rkalsdud/MARCO/보고서/MARCO_Phase1-1_결과보고서.docx

MARCO 프로젝트

Motor And Real-time Control Over CAN

Phase 1-1 결과 보고서

HAL CAN 루프백 — 설계·구현·검증

2026년 7월 6일

정정(2026-10-25): 디버그 모드 제약(5.3절)의 원인 판단과 규칙, 이와 연결된 5.1 표·결론 문장을 정정했다. 틀린 문장은 지우지 않고 취소선으로 남겼고, 바로 아래에 정정 문단을 붙였다.

정정(2026-10-25): 4.4절 풀업 이유 문장과 6장 표 ISSUE 001 원인 칸도 같은 방식으로 정정했다.

항목 | 내용
대상 보드 | STM32 Nucleo-F446RE (STM32F446RET6, ARM Cortex-M4 @ 84MHz)
개발 환경 | VSCode + STM32CubeIDE 확장 + STM32CubeMX + CMake
단계 | Phase 1-1 — HAL CAN 루프백 코드 작성 및 보드 검증
목표 | CAN1 루프백 모드에서 8바이트 데이터 송수신 일치 확인
결과 | RX OK 출력 확인 ✅

# 목차

1. 개요 및 목표

✓ 작업 요약

• HAL 라이브러리로 CAN1 루프백 모드를 구성하고 RM0390 기준 500kbps 비트 타이밍(BRP=5, TS1=11, TS2=2)을 계산해 적용했다.

• CAN RX 핀(PB8) 풀업 미설정으로 인한 Start 타임아웃 등 5건의 이슈(001~005)를 진단·해결했다.

• 8바이트 송수신 데이터 일치(RX OK)를 Serial Monitor로 확인했다.

2. 하드웨어 구성

3. CAN 설정 — 비트 타이밍 계산

4. 소프트웨어 구현

5. 검증 결과

6. 트러블슈팅 요약

7. 데이터시트 확인 항목

8. 결론

# 1. 개요 및 목표

Phase 1-1은 HAL 라이브러리를 이용해 CAN 루프백 통신을 구현하고 보드에서 직접 검증하는 단계다. 루프백 모드는 CAN 컨트롤러가 자신이 송신한 메시지를 내부적으로 수신 FIFO에 돌려주는 모드다. 트랜시버와 두 번째 보드 없이 USB 케이블 하나만으로 CAN 송수신 코드를 검증할 수 있다.

## 1.2 목표

목표 | 완료 기준
CAN1 루프백 모드 설정 | HAL_CAN_Start() 성공 (CAN Start: 0 출력)
8바이트 데이터 송신 | TX OK 출력
수신 인터럽트 처리 | HAL_CAN_RxFifo0MsgPendingCallback 동작
송수신 데이터 일치 확인 | Serial Monitor에 RX OK 출력
printf 리디렉션 | USART2 → ST-LINK 가상 COM → PC 터미널

# 2. 하드웨어 구성

## 2.1 사용 장비

장비 | 모델 | 역할
개발 보드 | STM32 Nucleo-F446RE | 메인 MCU 보드
연결 케이블 | USB A to Mini-B | PC-보드 연결, ST-LINK 전원 공급 및 통신
개발 PC | Windows 11 | 코드 작성, 빌드, Serial Monitor

## 2.2 핀 구성 (UM1724 + DS10693 기준)

기능 | 핀 | 연결 대상 | 참조 문서
CAN1_RX | PB8 (AF9) | 루프백 내부 (배선 불필요) | UM1724, DS10693
CAN1_TX | PB9 (AF9) | 루프백 내부 (배선 불필요) | UM1724, DS10693
USART2_TX | PA2 (AF7) | ST-LINK → 가상 COM 포트 | UM1724
USART2_RX | PA3 (AF7) | ST-LINK → 가상 COM 포트 | UM1724
LD2 (User LED) | PA5 | 동작 상태 표시 (1초 토글) | UM1724

## 2.3 클럭 구성

클럭 | 값 | 설정 근거
HSI 오실레이터 | 16MHz | 내부 RC 오실레이터 사용
PLL 설정 | PLLM=16, PLLN=336, PLLP=DIV4 | SystemClock_Config 코드
SYSCLK (HCLK) | 84MHz | 16/16 × 336 / 4 = 84MHz
APB1 클럭 | 42MHz | HCLK / 2 = 42MHz
CAN1 클럭 소스 | APB1 = 42MHz | RM0390 18장 확인 (×2 아님)

# 3. CAN 설정 — 비트 타이밍 계산

## 3.1 목표 보드레이트

목표 보드레이트는 500kbps로 설정했다. 500kbps는 자동차 파워트레인 CAN 버스의 표준 속도 중 하나다 (ISO 11898 기준). 트랜시버 연결 시 두 노드가 동일한 보드레이트를 사용해야 통신이 가능하다.

## 3.2 비트 타이밍 계산 과정

RM0390 18장의 CAN_BTR 레지스터 설명을 기준으로 계산했다.

보드레이트 공식 (RM0390 18장):
보드레이트 = CAN 클럭 / ((1+BRP) × (1+TS1+TS2))

목표: 500kbps, CAN 클럭 = 42MHz
500,000 = 42,000,000 / ((1+BRP) × (1+TS1+TS2))
(1+BRP) × (1+TS1+TS2) = 42,000,000 / 500,000 = 84

84 인수분해 → BRP=5 선택: (1+5) × 14 = 84
TQ 길이 = (1+BRP) × APB 주기 = 6 / 42MHz = 142.857ns
1비트 = 14TQ × 142.857ns = 2000ns = 2μs ✅ 500kbps

샘플링 포인트 (권장 75~87.5%):
TS1=11, TS2=2 선택 → 1+11+2 = 14TQ
샘플링 포인트 = (1+TS1) / (1+TS1+TS2) = 12/14 = 85.7% ✅

## 3.3 최종 설정값

파라미터 | 값 | 의미 | 허용 범위 (RM0390)
Prescaler (BRP+1) | 6 (BRP=5) | TQ 클럭 분주 | BRP: 0~1023 (10비트)
TimeSeg1 (TS1) | 11TQ | 샘플링 전 구간 | TS1: 0~15 (4비트)
TimeSeg2 (TS2) | 2TQ | 샘플링 후 구간 | TS2: 0~7 (3비트)
SyncJumpWidth (SJW) | 1TQ | 재동기화 최대 보정폭 | SJW: 0~3 (2비트)
샘플링 포인트 | 85.7% | (1+11)/(1+11+2)×100 | 권장: 75~87.5%
실제 보드레이트 | 500kbps | 42MHz / 6 / 14 | 목표: 500kbps

# 4. 소프트웨어 구현

## 4.1 CAN 초기화 코드

static void MX_CAN1_Init(void) {
hcan1.Instance = CAN1;
hcan1.Init.Prescaler = 6; // BRP=5 → 500kbps
hcan1.Init.Mode = CAN_MODE_LOOPBACK; // 루프백 모드
hcan1.Init.SyncJumpWidth = CAN_SJW_1TQ;
hcan1.Init.TimeSeg1 = CAN_BS1_11TQ; // TS1=11
hcan1.Init.TimeSeg2 = CAN_BS2_2TQ; // TS2=2
hcan1.Init.TimeTriggeredMode = DISABLE;
hcan1.Init.AutoBusOff = DISABLE;
hcan1.Init.AutoWakeUp = DISABLE;
hcan1.Init.AutoRetransmission = ENABLE;
hcan1.Init.ReceiveFifoLocked = DISABLE;
hcan1.Init.TransmitFifoPriority = DISABLE;
HAL_CAN_Init(&hcan1);
}

## 4.2 필터 설정 (전체 ID 허용)

CAN_FilterTypeDef sf;
sf.FilterBank = 0;
sf.FilterMode = CAN_FILTERMODE_IDMASK;
sf.FilterScale = CAN_FILTERSCALE_32BIT;
sf.FilterIdHigh = 0x0000; // ID = 0
sf.FilterIdLow = 0x0000;
sf.FilterMaskIdHigh = 0x0000; // Mask = 0 → 모든 ID 통과
sf.FilterMaskIdLow = 0x0000;
sf.FilterFIFOAssignment = CAN_RX_FIFO0;
sf.FilterActivation = ENABLE;
sf.SlaveStartFilterBank = 14; // CAN1(0~13) / CAN2(14~27) 분할
HAL_CAN_ConfigFilter(&hcan1, &sf);

## 4.3 송수신 코드 구조

/* 전역 변수 */

volatile uint8_t g_txData[8] = {0x11,0x22,0x33,0x44,0x55,0x66,0x77,0x88};

volatile uint8_t g_rxFlag = 0; // 수신 완료 플래그

volatile uint8_t g_matchResult = 0; // 데이터 일치 여부

volatile uint16_t g_txError = 0; // 송신 실패 카운터

/* CAN 시작 + 인터럽트 활성화 (USER CODE BEGIN 2) */

HAL_StatusTypeDef startRet = HAL_CAN_Start(&hcan1);

printf("CAN Start: %d CAN_error: %lx\r\n", (int)startRet, hcan1.ErrorCode);

// startRet=0(HAL_OK) 이어야 정상 — ISSUE 001에서 이 값이 1로 나와 원인을 추적함

HAL_StatusTypeDef notifRet = HAL_CAN_ActivateNotification(&hcan1,

CAN_IT_RX_FIFO0_MSG_PENDING | CAN_IT_TX_MAILBOX_EMPTY);

printf("CAN Notif: %d CAN_error: %lx\r\n", (int)notifRet, hcan1.ErrorCode);

/* while 루프 — 1초마다 송신 (USER CODE BEGIN 3) */

CAN_TxHeaderTypeDef tx = {0};

uint32_t mailbox;

tx.StdId = 0x123; // 11비트 표준 ID

tx.IDE = CAN_ID_STD;

tx.RTR = CAN_RTR_DATA;

tx.DLC = 8; // 8바이트

HAL_StatusTypeDef ret = HAL_CAN_AddTxMessage(&hcan1, &tx, (uint8_t*)g_txData, &mailbox);

if (ret != HAL_OK) {

g_txError++;

printf("TX ERROR: %d HAL_status: %d CAN_error: %lx\r\n",

g_txError, ret, hcan1.ErrorCode);

} else {

printf("TX OK\r\n");

}

if (g_rxFlag) {

g_rxFlag = 0;

if (g_matchResult) {

printf("RX OK\r\n");

} else {

printf("RX ERROR\r\n");

}

}

HAL_GPIO_TogglePin(GPIOA, GPIO_PIN_5); // LD2 토글 — 송신 시각화

printf("loop\r\n");

HAL_Delay(1000);

/* 수신 인터럽트 콜백 */

void HAL_CAN_RxFifo0MsgPendingCallback(CAN_HandleTypeDef *hcan) {

CAN_RxHeaderTypeDef rx;

uint8_t rxData[8];

HAL_CAN_GetRxMessage(hcan, CAN_RX_FIFO0, &rx, rxData);

// 송신 데이터와 수신 데이터 8바이트 비교

uint8_t match = 1;

for (int i = 0; i < 8; i++) {

if (rxData[i] != g_txData[i]) { match = 0; break; }

}

g_matchResult = match;

g_rxFlag = 1;

}

/* printf 리디렉션 (USART2 → ST-LINK 가상 COM) */

int __io_putchar(int ch) {

HAL_UART_Transmit(&huart2, (uint8_t*)&ch, 1, HAL_MAX_DELAY);

return ch;

}

## 4.4 GPIO 핀 풀업 설정 (핵심)

CAN RX 핀(PB8)에 풀업 저항을 설정해야 한다. ~~이 설정 없이는 CAN 컨트롤러가 idle 상태의 recessive 비트(연속 11개 HIGH)를 감지하지 못해 HAL_CAN_Start()가 타임아웃된다.~~

정정(2026-10-25): 풀업 설정은 유지하되 이유는 확인된 범위로 좁힌다. RM0390 Rev 9는 정상 모드 진입 전에 CANRX에서 recessive 11비트를 기다린다고 적고(30.4, 1021쪽), 루프백에서는 CANRX 핀 값을 무시한다고 적는다(30.5.2, 1024쪽). 실측으로는 트랜시버 없이 RX 핀이 떠 있던 이 루프백 시험에서 풀업 없이 Start가 타임아웃됐고 풀업으로 해결됐다(ISSUE 001). 루프백에서도 핀 상태가 영향을 준 기제는 확인하지 않았다. 트랜시버 R 출력이 핀을 구동하는 구성에서 풀업이 필요한지는 확인되지 않았다.

/* stm32f4xx_hal_msp.c — HAL_CAN_MspInit */
GPIO_InitStruct.Pin = GPIO_PIN_8 | GPIO_PIN_9;
GPIO_InitStruct.Mode = GPIO_MODE_AF_PP;
GPIO_InitStruct.Pull = GPIO_PULLUP; // ← 핵심. NOPULL이면 Start 실패
GPIO_InitStruct.Speed = GPIO_SPEED_FREQ_VERY_HIGH;
GPIO_InitStruct.Alternate = GPIO_AF9_CAN1;
HAL_GPIO_Init(GPIOB, &GPIO_InitStruct);

# 5. 검증 결과

## 5.1 검증 환경

항목 | 설정
업로드 방법 | STM32CubeProgrammer → ELF 업로드 → RESET 버튼
모니터링 방법 | VSCode Serial Monitor (COM5, 115200 baud, 8N1)
실행 방법 | Run Without Debugging ~~(디버그 모드 사용 불가 — 5.3 참조)~~ 정정(2026-10-25): 디버그 모드 사용 가능 여부는 확인되지 않았다(5.3 정정). 실행은 CubeProgrammer 업로드 뒤 RESET이며, Run Without Debugging은 보드에 코드를 올리지 않는다(ISSUE 002).

## 5.2 Serial Monitor 출력 (정상 동작)

아래는 실제 검증 시 Serial Monitor 캡처 화면이다.

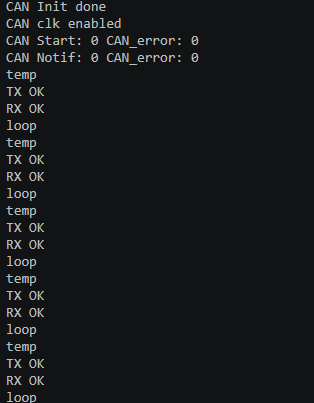
[picture p6: figure]

✓ 검증 완료 기준

HAL_CAN_Start() 반환값 0 (HAL_OK) → CAN 컨트롤러 정상 시작

TX OK → HAL_CAN_AddTxMessage() 성공

RX OK → 수신 인터럽트 발생 + 8바이트 데이터 일치 확인

loop → while 루프 1초 주기 정상 동작

LD2 → 1초 주기 토글 확인 (육안)

## 5.3 디버그 모드 제약

~~CAN은 실시간 페리퍼럴이다. GDB 디버거가 CPU를 브레이크포인트에서 멈추면, CAN 컨트롤러가 Init 모드(INAK)에서 정상 모드로 전환하는 타이밍이 깨진다. 그 결과 HAL_CAN_Start()가 0x20000 (Timeout) 에러를 반환한다.~~

정정(2026-10-25): ~~디버거가 원인이라는 판단은 근거가 성립하지 않는다.~~ 당시 CAN RX 핀(PB8)은 풀업 없이(GPIO_NOPULL) 떠 있었고, 디버거 없이 CubeProgrammer로 올려 RESET한 실행에서도 같은 0x20000이 났으며 풀업으로 바꾼 뒤 해결됐다(ISSUE 001). '디버거 없이 실행하니 정상'으로 본 실행은 보드에 새 코드를 올리지 않는 Ctrl+F5였다(ISSUE 002). 실제 원인은 RX 핀 풀업 누락일 가능성이 높다. ~~참고로 RM0390 Rev 9 기준 CAN_MCR의 DBF 리셋값은 1이라 코어가 디버그로 멈춘 동안 CAN 송수신이 동결된다(30.9.2, 1038쪽, 30.6).~~ 풀업 적용 뒤 디버그 실행으로 다시 시험하지 않았으며, Phase 3.7 작업 2에서 재시험한다.

재검토(2026-10-25): 위 정정 문단의 두 문장(취소선)은 단정이 과했다. 첫째, 같은 펌웨어를 디버거 없이 실행했을 때 정상 동작한 기록이 한 번 있다(Ctrl+F5 실행 때 보드에 남아 있던 펌웨어가 'TX OK'를 출력, 당시 대화). 그래서 디버거 가설에도 근거가 하나는 있었다. 다만 이후 디버거 없이 CubeProgrammer로 올린 실행에서도 같은 오류가 재현됐고 풀업으로 해결됐으므로, 디버거가 원인이라는 근거는 약하다. 핀이 떠 있으면 실행마다 결과가 달랐을 수 있다(추정). 둘째, DBF 리셋값은 1(디버그 중 송수신 동결로 기술)이지만, 30.6은 디버그 중 동작이 DBGMCU의 DBG_CANx_STOP 비트와 DBF 둘에 달려 있다고만 하고 조합 규칙은 적지 않아 '동결된다'고 단정할 수 없다.

⚠ CAN 검증 시 규칙

CAN 동작 확인: ~~Run Without Debugging +~~ STM32CubeProgrammer 업로드 + Serial Monitor

정정(2026-10-25): Run Without Debugging은 보드에 코드를 올리지 않는다(ISSUE 002). 업로드 뒤 RESET으로 실행한다.

변수 확인: printf 출력 방식으로 대체 (디버거 Watch 표현식 대신)

~~브레이크포인트: CAN Init/Start 이후 구간에서는 사용 금지~~

정정(2026-10-25): 근거가 확인되지 않은 규칙이다. 유지 여부는 Phase 3.7 작업 2의 디버그 재시험 뒤 정한다.

# 6. 트러블슈팅 요약

상세 내용은 MARCO_트러블슈팅_로그.docx를 참조한다.

번호 | 증상 | 원인 | 해결
001 | HAL_CAN_Start() 타임아웃 (error 0x20000) | CAN RX 핀(PB8) GPIO_NOPULL 설정 → ~~플로팅으로 recessive 비트 감지 불가~~ 정정(2026-10-25): 관측: 풀업 없이 Start가 타임아웃됐고 풀업으로 해결됐다. 루프백에서는 CANRX 핀 값을 무시한다는 RM0390 30.5.2와 어긋나 기제는 확인하지 않았다(4.4 정정). | GPIO_PULLUP으로 변경
002 | 코드 변경이 보드에 반영 안 됨 | ELF 파일을 PC에서 직접 실행 시도 | STM32CubeProgrammer로 플래시 업로드
003 | GDB 디버그 연결 실패 (error 138) | STM32CubeProgrammer가 ST-LINK를 점유한 채 실행 중 | CubeProgrammer 완전 종료 후 GDB 실행
004 | GDB 경로 디코딩 실패 | 프로젝트 경로에 한글 포함 | C:\Users\rkals\stm32-embedded-control으로 이동
005 | invalid storage class 빌드 에러 | while 루프 중괄호 불일치로 함수가 main 안에 중첩 | 중괄호 수정

7. 데이터시트 확인 항목

이 단계에서 직접 데이터시트를 열어 확인한 항목들이다. 코드 작성 및 배선의 근거가 된다.

항목 | 소스 | 찾은 내용 | 근거 위치
USART2_TX 핀 | UM1724 | PA2 | 7.10 USART communication 표
USART2_RX 핀 | UM1724 | PA3 | 7.10 USART communication 표
LD2 연결 핀 | UM1724 | PA5 | User LED 섹션
CAN1_TX 핀 | UM1724 + DS10693 | PB9 (AF9) | Morpho 커넥터 핀 배치표
CAN1_RX 핀 | UM1724 + DS10693 | PB8 (AF9) | Morpho 커넥터 핀 배치표
CAN1 클럭 소스 | RM0390 18장 | APB1 = 42MHz (×2 아님) | bxCAN 클럭 설명
CAN_BTR BRP 비트폭 | RM0390 18장 | 10비트 (0~1023) | CAN_BTR 레지스터
CAN_BTR TS1 비트폭 | RM0390 18장 | 4비트 (0~15) | CAN_BTR 레지스터
CAN_BTR TS2 비트폭 | RM0390 18장 | 3비트 (0~7) | CAN_BTR 레지스터
GPIO 최대 싱크 전류 | DS10693 | 25mA | Electrical characteristics

📌 데이터시트를 보지 않고 답변한 항목 (추후 확인 필요)

CAN 비트 타이밍 초기 계산값 (Prescaler=16, TimeSeg1=1TQ, TimeSeg2=1TQ) → 잘못된 값이었음

GPIO_NOPULL 설정 → 데이터시트 없이 기본값 사용 → CAN Start 실패 원인이 됨

위 두 항목은 실험적으로 발견하고 수정했으나 사전에 데이터시트로 확인했어야 했음

# 8. 결론

Phase 1-1의 목표를 달성했다. STM32F446RE의 CAN1 컨트롤러를 HAL 라이브러리로 루프백 모드에서 동작시키고, 8바이트 데이터의 송수신 일치를 Serial Monitor에서 확인했다.

이 과정에서 비트 타이밍 계산(RM0390 기준 500kbps), CAN RX 핀 풀업 설정, ~~디버거와 CAN 실시간 페리퍼럴의 충돌 등~~ 실무적인 이슈를 직접 경험하고 해결했다.

정정(2026-10-25): 디버거 충돌은 원인으로 확인되지 않았다(5.3절 정정).
