rkalsdud/MARCO/보고서/MARCO_Phase1-2_결과보고서.docx

MARCO 프로젝트

Motor And Real-time Control Over CAN

Phase 1-2 결과 보고서

CAN 트랜시버 배선 + 로직분석기 파형 검증

2026년 7월 7일

정정(2026-10-25): CAN 버스 전압과 로직분석기 임계값 서술(4장 박스, 5.2절)을 정정했다. 틀린 문장은 지우지 않고 취소선으로 남겼고, 바로 아래에 정정 문단을 붙였다.

정정(2026-10-25): 2.2 배선표의 CAN TX·CAN RX 행과 주의 박스도 같은 방식으로 정정했다.

보강(2026-10-26): 4장 박스의 재검토 문단 뒤에, 사용한 트랜시버 모듈 기판의 120Ω 종단저항을 실측으로 확인한 보강 문단을 붙였다.

항목 | 내용
대상 보드 | STM32 Nucleo-F446RE
추가 하드웨어 | SN65HVD230D CAN 트랜시버 모듈, TOL-18627 로직분석기 (24MHz/8ch)
단계 | Phase 1-2 — CAN 트랜시버 배선 + 로직분석기 파형 검증
목표 | 트랜시버를 통해 CAN 버스로 신호 출력 확인, PulseView로 프레임 디코딩
결과 | ID=0x123, DLC=8, Payload 일치 확인 ✅

# 목차

1. 개요 및 목표

✓ 작업 요약

• SN65HVD230D 트랜시버를 CAN1에 배선하고, 루프백 모드를 LOOPBACK(외부 출력 있음)으로 전환해 실제 신호를 트랜시버로 내보냈다.

• PulseView 로직분석기로 CAN_L 파형을 캡처해 ID=0x123, DLC=8, Payload 8바이트 일치를 확인했다.

• Silent 모드 오설정, 디코더 채널(CAN_H↔CAN_L) 오선택, 샘플레이트 부족 등 3건의 이슈(006~008)를 해결했다.

2. 하드웨어 구성 및 배선

3. 소프트웨어 설정

4. PulseView 설정

5. 검증 결과

6. 트러블슈팅 요약

7. 데이터시트 확인 항목

8. 결론

# 1. 개요 및 목표

Phase 1-2는 STM32 CAN1 컨트롤러와 SN65HVD230D 트랜시버를 연결하고, 로직분석기로 CAN_H/L 파형을 캡처해서 프레임 디코딩을 검증하는 단계다.

목표 | 완료 기준 | 결과
트랜시버 배선 | 전원 공급 + 신호선 연결 | ✅
로직분석기 CAN_L 파형 캡처 | 신호 변화 확인 | ✅
CAN 프레임 디코딩 | PulseView CAN 디코더 동작 | ✅
ID 확인 | 0x123 | ✅
DLC 확인 | 8바이트 | ✅
Payload 확인 | 0x11 0x22 0x33 0x44 0x55 0x66 0x77 0x88 | ✅

# 2. 하드웨어 구성 및 배선

## 2.1 사용 장비

장비 | 모델 | 역할
CAN 트랜시버 | SN65HVD230D 모듈 | CAN 컨트롤러 ↔ CAN 버스 신호 변환
로직분석기 | SparkFun TOL-18627 (24MHz/8ch) | CAN_H/L 파형 캡처
소프트웨어 | PulseView (sigrok) | 파형 시각화 + CAN 디코더

## 2.2 배선표

트랜시버 핀 | 연결 대상 | 비고
3.3V | STM32 CN6 4번 | 트랜시버 전원
GND | STM32 GND 핀 | 공통 GND
CAN TX | ~~STM32 PB8 (CN10 3번)~~ 정정(2026-10-25): STM32 PB9 (CN10 5번). 검증에 성공한 최종 배선 기준이다. 표의 값은 디버깅 중 TX·RX를 맞바꿔 시험한 배선으로 보인다(추정). | ~~트랜시버 입력 → STM32 CAN RX 방향 주의~~ 정정(2026-10-25): 모듈 'CAN TX'는 트랜시버 입력(D)이며 STM32 CAN1_TX(PB9)에 잇는다.
CAN RX | ~~STM32 PB9 (CN10 5번)~~ 정정(2026-10-25): STM32 PB8 (CN10 3번). | ~~트랜시버 출력 → STM32 CAN TX 방향 주의~~ 정정(2026-10-25): 모듈 'CAN RX'는 트랜시버 출력(R)이며 STM32 CAN1_RX(PB8)에 잇는다.
CAN H | 로직분석기 CH0 | CAN 버스 High 라인
CAN L | 로직분석기 CH1 | CAN 버스 Low 라인

⚠ 트랜시버 TX/RX 방향 주의

~~트랜시버 모듈의 'CAN TX'는 트랜시버 기준 명칭이다.~~

정정(2026-10-25): 모듈의 'CAN TX'·'CAN RX'는 STM32(CAN 컨트롤러) 쪽 신호 이름이다. 'CAN TX'(트랜시버 D 입력)에 PB9를, 'CAN RX'(R 출력)에 PB8을 잇는다. 아래 줄의 신호 방향은 최종 배선과 맞다.

STM32 PB9(CAN1_TX)의 신호를 트랜시버가 받아서 CAN 버스로 내보낸다.

모듈 핀 이름과 STM32 핀 이름의 TX/RX 방향이 혼동될 수 있어 배선 시 주의가 필요하다.

## 2.3 로직분석기 연결

로직분석기 핀 | 연결 대상 | PulseView 채널명
CH0 | 트랜시버 CAN H | CAN_H
CH1 | 트랜시버 CAN L | CAN_L
GND | STM32 GND 핀 | 기준 전위

## 2.4 배선 사진

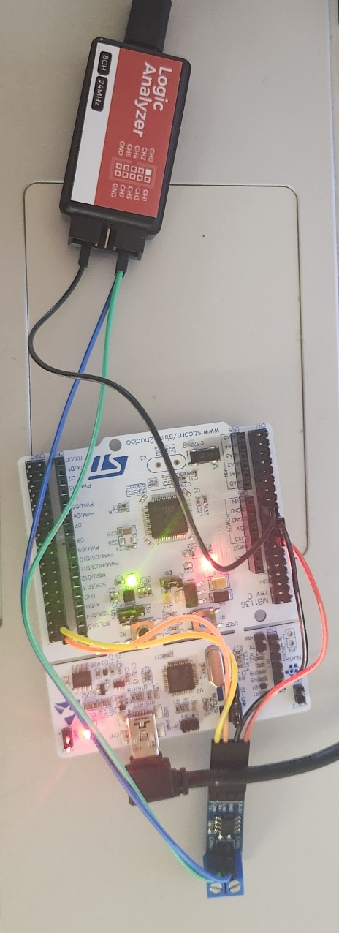
[picture p7: figure]

# 3. 소프트웨어 설정

## 3.1 비트 타이밍 계산 (500kbps)

RM0390 18장 CAN_BTR 레지스터 기준으로 계산했다. APB1 클럭은 SystemClock_Config에서 HCLK=84MHz, APB1DIV=2로 42MHz임을 확인했다.

파라미터 | 계산 | 결과
목표 보드레이트 | — | 500kbps (자동차 파워트레인 CAN 표준)
1비트 시간 | 1 / 500,000 | 2μs
총 TQ 수 결정 | 14TQ 선택 | 2μs / 14 = 142.857ns per TQ
BRP 계산 | 142.857ns = (1+BRP) / 42MHz → BRP=5 | Prescaler = 6
실제 보드레이트 검증 | 42MHz / 6 / 14 | 500kbps ✅
샘플링 포인트 | (1+11) / (1+11+2) = 12/14 | 85.7% (권장 75~87.5%) ✅

hcan1.Init.Prescaler = 6; // BRP+1, TQ = 6/42MHz = 142.857ns
hcan1.Init.SyncJumpWidth = CAN_SJW_1TQ;
hcan1.Init.TimeSeg1 = CAN_BS1_11TQ; // TS1 = 11TQ
hcan1.Init.TimeSeg2 = CAN_BS2_2TQ; // TS2 = 2TQ
// 42MHz / 6 / (1+11+2) = 500kbps, 샘플링 포인트 85.7%

## 3.2 CAN 모드 설정

트랜시버를 통해 외부 CAN 버스로 신호를 출력하려면 CAN_MODE_LOOPBACK으로 설정해야 한다. Silent 루프백 모드는 외부 핀으로 신호를 내보내지 않는다.

hcan1.Init.Mode = CAN_MODE_LOOPBACK; // 외부 TX 핀으로 신호 출력
hcan1.Init.AutoRetransmission = DISABLE; // ACK 없어도 동작

// CAN_MODE_SILENT_LOOPBACK은 외부 핀 신호 없음 → 사용 불가
// CAN_MODE_NORMAL은 ACK 필요 → 단일 노드에서 에러 발생

# 4. PulseView 설정

설정 항목 | 값 | 이유
Sample rate | 4MHz | 500kbps CAN 기준 비트당 8샘플 확보 (1MHz는 오독 발생)
Sample count | 1M | 0.25초 측정 (1초 주기 송신 기준 충분)
CAN 디코더 RX 채널 | CAN_L | Dominant 상태에서 CAN_L만 LOW로 변화
Nominal bitrate | 500000 | STM32 설정값과 일치
Sample point | 85.00 | 비트 타이밍 계산값 (85.7% 반올림)

📌 CAN 디코더를 CAN_L에 연결해야 하는 이유

~~Dominant(비트 0): CAN_H=3.5V(HIGH 유지), CAN_L=1.5V(LOW로 떨어짐)~~

~~Recessive(비트 1): CAN_H=2.5V(HIGH), CAN_L=2.5V(HIGH)~~

~~로직분석기 임계값 약 1.6V 기준으로 CAN_L의 1.5V만 LOW로 읽힘~~

정정(2026-10-25): 위 전압은 5V 트랜시버의 전형값으로, AI가 제공한 값을 데이터시트와 대조하지 않고 그대로 썼다. SN65HVD230(TI SLOS346O 8.5절, 7쪽, 3.3V 전원 기준): dominant에서 CANH 2.45V~VCC, CANL 0.5~1.25V, recessive에서 CANH·CANL 전형 2.3V, dominant 차동 전압 전형 2V. 로직분석기(SparkFun TOL-18627 제품 개요)는 LOW ≤ 0.8V, HIGH ≥ 2.0V이고 그 사이는 판독이 보장되지 않는다. "임계값 약 1.6V"는 출처가 없다. CAN_L 디코딩이 된 것은 실제 문턱이 당시 CANL 전압보다 높았기 때문이며(관측), 문턱과 버스 전압은 측정하지 않았다(버스 전압 실측은 Phase 5-a 작업 2).

재검토(2026-10-25): 위 SN65HVD230 값은 데이터시트 시험 조건(부하 저항 포함, Figure 18·19)의 값이다. 이 단계의 배선표에는 종단저항이 없으므로 실제 버스 전압은 이와 달랐을 수 있고, 측정하지 않았다.

보강(2026-10-26): 위 재검토의 '배선표에는 종단저항이 없으므로'는 배선표 기준의 서술이다. 사용한 SN65HVD230 모듈은 기판에 120Ω 칩저항(표기 121)이 실장된 제품이라(2026-10-26 실측, 모듈 단독 CANH–CANL 약 120Ω) 이 단계의 버스에는 그 120Ω 하나가 걸려 있었다. 데이터시트 시험 조건의 부하와 다르므로 버스 전압이 위 값과 달랐을 수 있다는 결론은 같고, 버스 전압은 측정하지 않았다. (Claude 작성, 외부 검토 전)

교훈(2026-10-25): 수치는 출처가 무엇이든 받아들이기 전에 데이터시트와 대조한다(트러블슈팅 로그 ISSUE 022 정정 이력과 같은 교훈).

CAN_H는 항상 HIGH라 변화 감지 불가

# 5. 검증 결과

## 5.1 PulseView 캡처 결과

아래는 실제 검증 시 PulseView 파형 캡처 화면이다. CAN_L에 펄스가 보이고 CAN: Fields에서 ID, DLC, Payload가 디코딩된다.

확인 항목 | 기대값 | 측정값 | 결과
Identifier (ID) | 0x123 (291) | 0x123 (291) | ✅
DLC | 8바이트 | 8바이트 | ✅
Payload | 11 22 33 44 55 66 77 88 | 11 22 33 44 55 66 77 88 | ✅
CAN_L 파형 | Dominant 구간에서 LOW | LOW 구간 확인 | ✅
프레임 주기 | 약 1초 | 1초 주기 반복 | ✅

✓ Phase 1-2 검증 완료

트랜시버가 STM32 CAN 신호를 CAN 버스 차동 신호로 정상 변환하고 있음

PulseView에서 ID, DLC, Payload 모두 일치 확인

CAN 프레임 구조 (SOF, ID, DLC, Data, CRC, EOF) 정상 디코딩

## 5.2 로직분석기 한계 사항

일반 디지털 로직분석기는 CAN 차동 신호를 직접 측정하지 못한다. CAN_H/L 전압 레벨~~(Dominant: H=3.5V/L=1.5V, Recessive: 둘 다 2.5V)~~을 정확히 측정하려면 차동 프로브 또는 멀티미터가 필요하다.

정정(2026-10-25): SN65HVD230 기준값은 4장 박스의 정정 문단 참조. 위 괄호의 값은 5V 트랜시버 전형값이다.

⚠ 로직분석기 측정 한계

CAN idle 상태: ~~CAN_H=2.5V, CAN_L=2.5V~~ → 로직분석기는 둘 다 HIGH로 읽음

Dominant 상태: ~~CAN_L=1.5V → 로직분석기 임계값(약 1.6V) 이하라~~ LOW로 읽힘

CAN_H는 항상 HIGH로 읽혀 파형 변화 미감지

정확한 전압 측정은 멀티미터 필요 (현재 미보유)

정정(2026-10-25): 위 두 줄의 전압과 임계값은 근거가 없다. recessive는 CANH·CANL 전형 2.3V, dominant CANL은 0.5~1.25V이며, 로직분석기 판독 기준은 LOW ≤ 0.8V, HIGH ≥ 2.0V다(4장 박스 정정). dominant CANL은 보장되지 않는 구간에 걸치지만 실제로는 LOW로 읽혔다(관측).

재검토(2026-10-25): SN65HVD230 값은 데이터시트 시험 조건(부하 포함) 기준이다(4장 박스 재검토).

# 6. 트러블슈팅 요약

상세 내용은 MARCO_트러블슈팅_로그.docx를 참조한다.

번호 | 증상 | 원인 | 해결
006 | PB9에서 신호 없음 | CAN_MODE_SILENT_LOOPBACK은 외부 핀으로 신호 미출력 | CAN_MODE_LOOPBACK으로 변경
007 | PulseView CAN 디코더 동작 안 함 | CAN RX 채널을 CAN_H로 설정 → 변화 감지 불가 | CAN RX 채널을 CAN_L로 변경
008 | Payload 오독 (일부 바이트 틀림) | Sample rate 1MHz → 비트당 2샘플로 부족 | Sample rate 4MHz로 상향

7. 데이터시트 확인 항목

이 단계에서 직접 데이터시트를 열어 확인한 항목들이다.

항목 | 소스 | 찾은 내용 | 근거 위치
CAN1_TX/RX Morpho 위치 | UM1724 | PB8=CN10 3번, PB9=CN10 5번 | 커넥터 핀 배치표
SN65HVD230 핀 배치 | SN65HVD230 데이터시트 | D=1, GND=2, VCC=3, R=4, Vref=5, CANL=6, CANH=7, Rs=8 | Pin configuration
Rs 핀 모드 | SN65HVD230 데이터시트 | GND=고속모드, 저항=슬로프제어 | Rs 핀 설명
APB1 최대 클럭 | DS10693 | 42MHz (Over-drive OFF) | Internal APB1 clock frequency 표
TIM3 최대 타이머 클럭 | DS10693 | 90MHz (TIMPRE=0) | Table 60. TIMx characteristics
TIMPRE 리셋값 | RM0390 RCC 장 | 0 (RCC_DCKCFGR 리셋값 0x0) | RCC_DCKCFGR 레지스터
TIM3 클럭 계산 | RM0390 RCC 장 | APB1 prescaler>1 → ×2 = 84MHz | TIMPRE=0 타이머 클럭 설명
500kbps 비트 타이밍 | RM0390 18장 | BRP=5, TS1=11, TS2=2, 샘플링포인트 85.7% | CAN_BTR 레지스터

⚠ 데이터시트 확인 없이 진행했던 항목

CAN_MODE_SILENT_LOOPBACK 동작 → 외부 신호 없음을 몰라서 시행착오 발생

PulseView CAN RX 채널 → CAN_H/CAN_L 차이를 실험으로 확인 (사전에 CAN 물리 계층 이해로 예측 가능)

Sample rate → 나이퀴스트 기준으로 사전 계산 가능했지만 실험적으로 확인

# 8. 결론

Phase 1-2의 목표를 달성했다. SN65HVD230D 트랜시버를 STM32 CAN1 컨트롤러에 연결하고, PulseView 로직분석기로 CAN_L 파형을 캡처해서 ID=0x123, DLC=8, Payload 완전 일치를 확인했다.
