rkalsdud/MARCO/보고서/MARCO_Phase1-7_결과보고서.docx

MARCO 프로젝트

Motor And Real-time Control Over CAN

Phase 1-7 결과 보고서 — HAL → 베어메탈 전환

2026년 7월 28일 완료

정정(2026-10-25): CAN RX 풀업 서술(4.1 표, 5.3 박스)과 관련 ISSUE 번호(4.5·5.3 박스)를 정정했다. 틀린 문장은 지우지 않고 취소선으로 남겼고, 바로 아래에 정정 문단을 붙였다.

정정(2026-10-25): 1.1 목적 문장, 7장 페리퍼럴 개수, 9장 이슈 목록도 같은 방식으로 정정했다.

정정(2026-10-25): 3장 대조 항목 수와 4.4 SMPR1 행도 같은 방식으로 정정·보강했다.

GPIO/PWM/CAN/ADC 베어메탈 전환 및 최종 코드 정리(죽은 HAL 코드 제거)까지 완료한 최종 보고서다.

# 1. 개요

✓ 작업 요약

• GPIO, PWM, CAN1/CAN2, ADC를 각각 HAL 버전과 베어메탈 버전으로 구현하고 데이터시트(RM0390, DS10693) 기준으로 레지스터 값을 전수 검증했다.

• 레지스터 참조표와 HAL↔베어메탈 함수 대응표를 정리해 각 레지스터/함수의 역할을 문서화했다.

• 베어메탈 전환 과정에서 발생한 6건의 이슈(핀 AF 누락, 풀업 누락 등)를 진단·해결했다.

## 1.1 목적

Phase 1-1~1-6에서 HAL 라이브러리로 구현한 GPIO, PWM, CAN 초기화 및 제어 코드를 CMSIS 레지스터 직접 조작(베어메탈) 방식으로 전환한다. HAL이 내부적으로 수행하는 레지스터 조작을 데이터시트(RM0390, DS10693) 기준으로 직접 확인하고 재구현함으로써, ~~추상화 계층 없이도 페리퍼럴을 완전히 이해하고 제어할 수 있음을 증명한다.~~

정정(2026-10-25): 과장이다. 베어메탈 ADC 초기화에 ADC 클럭 분주(ADC_CCR.ADCPRE) 설정이 없어 ADC 클럭이 42MHz(PCLK2 84MHz ÷ 리셋값 2)로 DS10693 상한 36MHz를 넘었다(외부평가 A7, Phase 1-5 3.1 보강). 이 단계의 범위는 HAL로 구현한 동작을 레지스터 직접 조작으로 재현한 것까지다.

## 1.2 대상 범위

대상 | 전환 상태 | 비고
GPIO (모터 방향 제어: PC0/PC1/PC2) | 완료 ✅ | BSRR 기반, HAL과 동일 파형 확인
PWM (TIM3, PA6) | 완료 ✅ | PA6 AF2 설정 포함, 1kHz 유지
CAN (CAN1, 루프백) | 완료 ✅ | 필터/BTR/인터럽트 포함, match=1 확인
ADC (가변저항, PC3) | 완료 ✅ | Phase 1-5에서 배선 및 실측 검증 완료
HAL 초기화 완전 제거 | 완료 ✅ | 9장 참조 — 본 문서에서 일괄 정리 완료

## 1.3 진행 순서

가변저항 부품이 도착하지 않은 상태에서 순서를 조정해 진행했다. ADC를 제외한 GPIO → PWM → CAN 순으로 먼저 전환하고, ADC 베어메탈 코드는 부품 도착 후 이어서 작성하기로 했다.

# 2. 계산 근거

## 2.1 시스템 클럭 구성

HSI(16MHz) → PLL → SYSCLK 84MHz. APB1 타이머 클럭 84MHz, APB2 84MHz (SystemClock_Config 기준).

## 2.2 PWM (TIM3) 주파수/듀티 계산

항목 | 값 | 계산식
PSC | 83 | 84MHz / (83+1) = 1MHz
ARR | 999 | 1MHz / (999+1) = 1kHz
CCR1 (듀티) | 0~999 | duty / 1000 × 100%
실사용 듀티 | 750 | 750/1000 = 75%

## 2.3 CAN 비트 타이밍 계산

HAL 설정값(Prescaler=6, BS1=11TQ, BS2=2TQ) 기준으로 베어메탈 BTR 레지스터에 대응하는 값을 아래와 같이 산출했다.

BTR 필드 | 설정값 | 의미
BRP[9:0] | 5 | Prescaler = BRP+1 = 6
TS1[19:16] | 10 | BS1 = TS1+1 = 11TQ
TS2[22:20] | 1 | BS2 = TS2+1 = 2TQ
SJW[25:24] | 0 | SJW = SJW+1 = 1TQ
LBKM[30] | 1 | 루프백 모드 활성화

1 비트 시간 = 1(동기) + 11(BS1) + 2(BS2) = 14 TQ. 이 값과 BRP를 조합해 500kbps 근사 통신속도를 구성했다 (HAL 설정과 동일).

# 3. 구현 — 데이터시트 대조 검증

베어메탈 가이드 문서에 기재한 레지스터 비트 위치를 RM0390/DS10693에서 직접 대조해 전수 검증했다. 전체 18개 항목 모두 문서 기재값과 일치함을 확인했다.

보강(2026-10-25): 아래 표는 16행이다. 18은 필드 단위로 센 값일 수 있으나 세는 기준은 확인하지 않았다. 또 이 대조는 가이드 문서에 적은 비트 위치를 확인한 것이라, 가이드에 없던 설정은 대상이 아니었다. ADC 클럭 분주(ADC_CCR.ADCPRE) 누락은 이 대조로 잡히지 않았다(외부평가 A7, 1.1 정정).

레지스터 | 필드 | 값 | 확인
RCC AHB1ENR | GPIOAEN / GPIOCEN | 비트0 / 비트2 | ✅
RCC APB1ENR | TIM3EN / CAN1EN | 비트1 / 비트25 | ✅
RCC APB2ENR | ADC1EN | 비트8 | ✅
GPIOx_MODER | 모드값 4종 | 00/01/10/11 | ✅
GPIOx_OTYPER | Push-Pull/Open-Drain | 0/1 | ✅
GPIOx_BSRR | SET/RESET | 하위16/상위16 | ✅
GPIOx_AFR | 핀당 비트폭 | 4비트 | ✅
DS10693 | PA6 / PC3 | AF2(TIM3_CH1) / ADC123_IN13 | ✅
TIMx_CCMR1 | OC1M | [6:4], 110=PWM1 | ✅
TIMx_CCER | CC1E | 비트0 | ✅
TIMx_CR1 | CEN | 비트0 | ✅
TIMx_PSC/ARR | 비트폭 | 16비트 | ✅
CAN_BTR | BRP/TS1/TS2/SJW/LBKM | 본문 2.3 참조 | ✅
ADC CR2 | ADON/SWSTART | 비트0 / 비트30 | ✅
ADC SR | EOC | 비트1 | ✅
ADC SQR3 | SQ1 | [4:0] | ✅

# 4. 레지스터 참조표

3장이 값의 정확성(데이터시트 일치 여부)을 다뤘다면, 이 장은 각 레지스터가 실제로 무슨 역할을 하며 왜 우리 코드에 필요한지를 정리한다. 나중에 이 문서만 보고도 레지스터의 기능을 떠올릴 수 있도록 하는 것이 목적이다.

## 4.1 GPIO

레지스터 | 역할 | 이 프로젝트에서의 목적
MODER | 핀의 기본 동작 모드 결정 (입력/출력/AF/아날로그) | PC0~PC2를 출력으로, PA6/PC3을 AF·아날로그로 전환
OTYPER | 출력 방식 결정 (Push-Pull/Open-Drain) | 모터 제어 핀을 Push-Pull로 설정해 HIGH/LOW를 능동 구동
BSRR | 핀을 원자적으로 SET/RESET | STBY/AIN0/AIN1을 read-modify-write 없이 안전하게 제어
AFR[0]/AFR[1] | 핀을 특정 페리퍼럴 신호선에 연결 | PA6→TIM3_CH1(AF2), PB8/PB9→CAN1(AF9) 매핑
PUPDR | 입력 핀의 유휴 상태 고정 (풀업/풀다운) | ~~CAN1_RX(PB8)를 풀업해 버스 유휴 상태(recessive)를 안정적으로 유지~~ 정정(2026-10-25): CAN1_RX(PB8)에 풀업을 건다. RX 핀이 떠 있는 구성에서 정상 모드 진입이 실패한 이력(ISSUE 001)에 대한 대비이며, 트랜시버가 핀을 구동하는 구성에서 필요한지는 확인되지 않았다(트러블슈팅 로그 ISSUE 001 교훈 정정).

## 4.2 TIM3 (PWM)

레지스터 | 역할 | 이 프로젝트에서의 목적
PSC | 타이머 입력 클럭을 분주 | 84MHz → 1MHz로 낮춰 다루기 쉬운 카운트 단위 확보
ARR | 카운터가 리셋되는 상한값 (주기 결정) | 999로 설정해 1kHz PWM 주기 생성
CCR1 | 채널1의 비교값 (듀티 결정) | 값이 클수록 HIGH 구간이 길어져 모터 속도 증가
CCMR1 (OC1M) | 채널의 출력 비교 동작 모드 선택 | PWM mode 1(110)로 설정해 CCR1 이하 구간에서 HIGH 출력
CCER (CC1E) | 채널 출력을 실제 핀에 연결할지 결정 | 내부 PWM 신호를 PA6 핀까지 실제로 내보내는 스위치 역할
CR1 (CEN) | 타이머 카운터 동작 시작/정지 | 모든 설정이 끝난 뒤 마지막에 켜서 타이머 시작

## 4.3 CAN1

레지스터 | 역할 | 이 프로젝트에서의 목적
MCR (INRQ) | 초기화 모드 진입/해제 요청 | 설정 변경 전 초기화 모드로, 완료 후 Normal 모드로 전환
MSR (INAK) | 초기화 모드 진입 완료를 하드웨어가 확인 | INRQ 요청에 대한 응답 대기 — 핸드셰이크 구조
BTR | 비트 타이밍(BRP/TS1/TS2/SJW) 및 루프백 모드 | 500kbps 근사 통신 속도 구성, 테스트용 루프백 활성화
MCR (NART) | 자동 재전송 여부 | 0으로 설정해 실패한 프레임을 자동 재전송하도록 함
FMR (FINIT) | 필터 뱅크 설정 모드 잠금/해제 | 필터값을 바꾸는 동안 수신에 영향 없도록 보호
FA1R | 필터 뱅크 활성화 여부 | 필터 뱅크 0번을 사용하도록 활성화
sFilterRegister (FR1/FR2) | 필터 ID값과 마스크값 | 마스크 전부 0 → 모든 ID를 허용(전체 수신)
IER (FMPIE0) | FIFO0 메시지 수신 인터럽트 활성화 | 메시지 도착 시 인터럽트로 즉시 처리하기 위함
TSR / TIR / TDTR / TDLR / TDHR | 송신 메일박스 상태 확인 및 프레임 구성 | 메일박스가 빈 것을 확인 후 ID/길이/데이터를 채워 송신
RF0R | 수신 FIFO0 상태, 메시지 존재 여부 및 릴리즈 | 메시지 유무 확인 및 처리 후 FIFO 슬롯 반환

## 4.4 ADC1

레지스터 | 역할 | 이 프로젝트에서의 목적
CR2 (ADON) | ADC 회로 전원 스위치 | 변환 전 ADC 하드웨어를 활성화
CR2 (SWSTART) | 소프트웨어 트리거로 변환 시작 | 가변저항 값 측정이 필요한 시점마다 변환 개시
SQR3 (SQ1) | 정규 변환 시퀀스의 1번째 채널 지정 | 채널13(PC3)을 유일한 변환 대상으로 지정
SMPR1 | 채널별 샘플링(충전) 시간 설정 | ~~느리게 변하는 가변저항 신호라 기본 3 cycles로 충분~~ 정정(2026-10-25): 근거 미확인. ~~3 cycles를 고른 근거는 기록돼 있지 않고,~~ DS10693의 외부 입력 임피던스 조건(Table 74 RAIN, Equation 1)과 대조하지 않았다(외부평가 A7). 당시 ADC 클럭은 사양 밖(42MHz)이었다. 재검토(2026-10-25): 취소선 구절은 사실과 다르다. 3 cycles는 CubeMX·HAL 설정값(ADC_SAMPLETIME_3CYCLES)을 그대로 옮긴 것이다(당시 대화 기록). 보고서에 그 출처를 적지 않았고, 전기적 근거(RAIN, Equation 1)와는 대조하지 않았다.
SR (EOC) | 변환 완료 여부 플래그 | 이 비트가 설 때까지 대기한 뒤 결과를 읽어야 정확한 값 확보
DR | 변환 결과 12비트 값 저장 | 읽는 순간 EOC가 자동으로 클리어됨

## 4.5 HAL 함수 ↔ 베어메탈 함수 대응표

4.1~4.4가 레지스터 단위의 대응이라면, 이 절은 실제 코드에서 호출하는 함수 단위의 대응이다. 각 페리퍼럴마다 HAL 버전과 베어메탈 버전 함수를 나란히 만들어 성능 비교(Phase 2) 및 상호 검증에 활용했다.

동작 | HAL 방식 | 베어메탈 함수 | 비고
모터 정방향 | Motor_Forward() (HAL_GPIO_WritePin ×3) | Motor_Forward_Bare()
모터 역방향 | Motor_Backward() (HAL_GPIO_WritePin ×3) | Motor_Backward_Bare()
모터 정지 | Motor_Stop() (HAL_GPIO_WritePin) | Motor_Stop_Bare()
PWM 듀티 설정 | Motor_SetSpeed() (__HAL_TIM_SET_COMPARE) | Motor_SetSpeed_Bare() | 매크로 기반, 성능差 없음
ADC 값 읽기 | ADC_Read() (HAL_ADC_Start 등 4개 함수) | ADC_Read_Bare() | MX_ADC1_Init() 없이는 미동작
TIM3 PWM 초기화 | MX_TIM3_Init() + HAL_TIM_PWM_Start() | TIM3_PWM_Init_Bare() | PA6 AF 설정 포함
CAN1 초기화 | MX_CAN1_Init() + Config/Start/Notify | CAN1_Init_Bare() | 필터·BTR·인터럽트 포함
ADC1 초기화 | MX_ADC1_Init() | ADC1_Init_Bare() | SQR3·SMPR1 포함

⚠ 함께 쓸 때 주의할 점

• HAL 버전 함수는 대응하는 MX_..._Init() 이 호출된 상태에서만 정상 동작한다.

• 베어메탈로 전환한 뒤 HAL 버전 함수(예: ADC_Read())를 그대로 호출하면, HAL 내부 핸들 구조체가 초기화되지 않아 조용히 실패하거나 아무 값도 반환하지 않는다.

• 두 버전을 비교 목적으로 남겨둘 때는 이 제약을 항상 염두에 두고, 실제 실행 경로에는 베어메탈 버전만 남기는 것이 안전하다 ~~(ISSUE 002, 014와 같은 원인)~~.

정정(2026-10-25): 같은 원인의 이슈는 초기화되지 않은 HAL 핸들을 쓴 ISSUE 025·027이다. ISSUE 002(ELF를 PC에서 실행)와 014(HAL과 베어메탈 동시 초기화)는 원인이 다르다.

# 5. 검증

## 5.1 GPIO 베어메탈

로직분석기로 PC0/PC1/PC2 파형을 HAL 버전과 비교해 동일함을 확인했다. Forward/Backward/Stop 3개 상태 전환이 정상 동작했다.

## 5.2 PWM 베어메탈

PA6 파형이 1kHz로 정상 출력됨을 확인했다. AF 설정 누락 시 UART까지 영향을 받는 부수 효과를 ISSUE 013에서 확인했다 (상세는 트러블슈팅 로그 참조).

## 5.3 CAN 베어메탈

초기화, 필터, 비트 타이밍, 인터럽트까지 전 구간을 베어메탈로 전환한 뒤 루프백 송수신 테스트에서 match=1(송수신 데이터 일치)을 확인했다. 전환 과정에서 총 6건의 이슈(013~018)가 발생했으며 전부 해결했다.

⚠ 반복적으로 발생한 패턴

• CAN RX 핀(PB8) 풀업 누락이 ISSUE 001과 ISSUE 017에서 두 차례 재발했다.

보강(2026-10-25): 풀업 없이 실패가 확인된 구성은 RX 핀을 구동하는 것이 없던 ISSUE 001이다. ISSUE 017 시점의 트랜시버 연결 여부는 기록이 엇갈린다. "RX 핀에는 반드시 풀업"으로 일반화하지 않는다.

• HAL의 MspInit 계열 함수가 레지스터 설정 외에도 핀 AF 설정을 함께 수행하고 있어, 이를 놓치면 초기화 단계에서 정지하는 문제가 반복됐다 (ISSUE 016).

• 동일 페리퍼럴을 HAL과 베어메탈로 동시에 초기화하면 상태가 꼬인다 ~~(ISSUE 002, 014)~~.

정정(2026-10-25): ISSUE 002는 ELF를 PC에서 실행하려 한 문제라 해당하지 않는다. 해당 이슈는 ISSUE 014다.

# 6. 트러블슈팅 요약

본 단계에서 발생한 이슈 목록이다. 상세 원인 분석과 해결 과정은 MARCO_트러블슈팅_로그.docx를 참조한다.

번호 | 제목 | 핵심 원인 | 상태
013 | AFR 클리어 시 UART 먹통 | ~ 연산자 누락 | 해결 ✅
014 | CAN 0xC0000 에러 | HAL/베어메탈 CAN 동시 초기화 | 해결 ✅
015 | g_txData undefined reference | extern 선언 누락 | 해결 ✅
016 | CAN 초기화 무한 대기 | PB8/PB9 AF9 설정 누락 | 해결 ✅
017 | CAN Normal 모드 진입 실패 | PUPDR을 PB9에 잘못 적용 | 해결 ✅
018 | CAN 루프백 match=0 | TX 값과 g_txData 출처 불일치 | 해결 ✅

# 7. 결론

GPIO, PWM, CAN 3개 페리퍼럴의 베어메탈 전환을 완료하고 HAL 버전과 동일한 동작을 확인했다. 전환 과정에서 발생한 6건의 이슈는 대부분 HAL이 내부적으로 처리하던 핀 AF 설정, 풀업 설정, 초기화 순서를 베어메탈에서는 명시적으로 챙겨야 한다는 공통점을 보였다.

보강(2026-10-25): 3개는 7장 작성 시점 기준이다. 8.3절의 최종 범위는 ADC를 더한 4종(GPIO/PWM/CAN/ADC)이고, 9장은 CAN1·CAN2를 나눠 5개로 센다.

✓ 이번 단계에서 확인한 핵심 교훈

• HAL의 페리퍼럴 Init 함수는 레지스터 설정뿐 아니라 관련 GPIO의 AF/풀업 설정까지 함께 수행한다.

• 베어메탈 전환 시 이 숨은 설정들을 빠짐없이 옮기지 않으면 초기화 단계에서 조용히 멈춘다.

• 값의 출처(Single Source of Truth)를 하나로 유지하지 않으면 부분적으로만 반영된 수정이 새로운 버그를 만든다.

8. 최종 코드 정리

가변저항 도착 및 Phase 1-5/1-6 완료로 데이터시트 확인 항목이 모두 실측 검증됐으므로, 남아있던 HAL 초기화 잔재를 정리해 Phase 1-7을 완결했다.

8.1 구조 정리 — Phase별 #ifdef 구획

함수 정의 구역(USER CODE BEGIN 0)과 while(1) 내부 실행 로직을 Phase 단위 주석/전처리 블록으로 구분해 가독성을 확보했다.

// <------ phase 1------>

... GPIO/PWM/ADC/엔코더/PID 함수 ...

// <------ phase 1------>

// <------- phase2 ------>

... DWT, 양자화, 이동평균 필터 ...

// <-------phase 2------>

// <-------phase 3------>

... CAN1_Init_Bare, CAN2_Init_Bare ...

// <-------phase 3------>

8.2 삭제된 항목

항목 | 삭제 사유
MX_CAN1_Init() | CAN1_Init_Bare()로 완전 대체
MX_TIM3_Init() | TIM3_PWM_Init_Bare()로 완전 대체 (PA6 AF 설정 포함)
MX_ADC1_Init() | ADC1_Init_Bare()로 완전 대체
g_rxFlag, g_matchResult | CAN1 루프백 match 검증용 — ID 기반 게이트웨이 로직으로 대체되어 미사용
g_txError | 어디서도 참조되지 않던 죽은 변수
g_txData[] | 루프백 테스트 데이터 — 이제 CAN 메시지는 direction/targetDuty 등 실제 필드로 직접 구성
HAL_CAN_RxFifo0MsgPendingCallback (주석) | CAN1_RX0_IRQHandler로 대체된 죽은 콜백

8.3 유지한 HAL 코드와 그 이유

유지 항목 | 이유
MX_GPIO_Init() | GPIOA/B/C 클럭 활성화 등 인프라 역할 — 베어메탈 함수들이 이 초기화에 의존
MX_USART2_UART_Init() | printf 디버그 출력 전용. 저빈도 호출이라 성능 비교 의미가 없고, Phase 1-7의 대상 범위(GPIO/PWM/CAN/ADC) 밖

Phase 1-7의 완성 기준은 "모든 HAL 제거"가 아니라 "성능·이해도 증명 대상으로 선정한 4개 페리퍼럴(GPIO/PWM/CAN/ADC)의 베어메탈 전환과 실측"이다. UART나 클럭 인프라까지 무리하게 전환하는 것은 이 기준을 벗어난 과잉 작업으로 판단해 제외했다.

9. Phase 1-7 최종 결론

작업 요약

• GPIO, PWM, CAN1, CAN2, ADC 5개 페리퍼럴 전부 베어메탈 전환 및 HAL 버전과의 동작 일치를 실측 검증했다.

• 레지스터 참조표, HAL↔베어메탈 함수 대응표를 작성해 각 레지스터·함수의 역할을 문서화했다.

• ~~총 7건의 관련 이슈(ISSUE 002, 010, 013, 014, 025, 027 등)~~를 진단·해결했다.

정정(2026-10-25): HAL·베어메탈 전환 관련 이슈는 ISSUE 010, 013~018, 025, 027이다. ISSUE 002(ELF를 PC에서 실행)는 해당하지 않고, 원문의 건수(7건)는 목록과 맞지 않았다. 5.3절의 6건(013~018)은 Phase 1-7 전환 과정만 센 것이다.

• 죽은 HAL 코드와 미사용 전역 변수를 정리해 최종 코드 상태를 확정했다.
