rkalsdud/MARCO/보고서/MARCO_Phase2_결과보고서.docx

MARCO 프로젝트

Motor And Real-time Control Over CAN

Phase 2 결과 보고서 — 정량적 성능 비교

2026년 7월 24일 완료

정정(2026-10-25): 6장 종합표 GPIO 행의 해석을 정정했다. 틀린 문장은 지우지 않고 취소선으로 남겼고, 바로 아래에 정정 문단을 붙였다.

정정(2026-10-25): 5장 축3의 노이즈 수치에 측정 조건 보강을 붙였다.

본 보고서는 축1(추상화), 축2(수치표현), 축3(필터) 세 축 전체의 측정 결과를 다룬다.

# 1. 개요

✓ 작업 요약

• DWT 사이클 카운터로 HAL 함수와 베어메탈 코드의 실행 사이클을 실측 비교했다.

• GPIO(함수 기반 HAL)는 3.4배, PWM(매크로 기반 HAL)은 차이 없음을 확인했다.

• 나눗셈 대신 고정소수점 양자화를 적용해 1.67배 속도 개선(오차 ±1)을 확인했다.

• 원시 ADC 값과 이동평균 필터를 비교해 34% 사이클 비용으로 노이즈 약 56% 감소를 확인했다.

## 1.1 목적

Phase 1-7에서 HAL과 베어메탈로 각각 구현한 코드가 실제로 얼마나 성능 차이를 보이는지 정량적으로 측정한다. "베어메탈이 빠르다"는 막연한 통념이 아니라, 클럭 사이클 단위의 실측값으로 그 차이를 증명하는 것이 목표다.

## 1.2 측정 축

축 | 비교 대상 | 상태
축1 — 추상화 비용 | HAL 함수 vs 베어메탈 레지스터 직접 조작 | 완료 ✅
축2 — 수치 표현 | 나눗셈(정수) vs 양자화(고정소수점 곱셈+시프트) | 완료 ✅
축3 — 필터 | 원시 ADC 값 vs 이동평균 필터 | 완료 ✅

## 1.3 측정 도구

ARM Cortex-M4 코어에 내장된 DWT(Data Watchpoint and Trace) 사이클 카운터를 사용했다. 코어 클럭 1회당 1씩 증가하는 하드웨어 카운터로, 소프트웨어 기반 시간 측정(HAL_GetTick 등)보다 훨씬 정밀하다.

void DWT_Init(void){

CoreDebug->DEMCR |= CoreDebug_DEMCR_TRCENA_Msk;

DWT->CYCCNT = 0;

DWT->CTRL |= DWT_CTRL_CYCCNTENA_Msk;

}

uint32_t DWT_GetCycles(void){ return DWT->CYCCNT; }

측정 도구 자체의 오버헤드는 DWT_GetCycles() 호출 두 번을 연달아 실행해 검증했다. 결과는 18 cycles로 일정하게 반복되어, 측정 도구가 노이즈 없이 안정적으로 동작함을 확인했다.

# 2. 측정 환경

## 2.1 빌드 설정 이슈

초기 측정에서 Debug/Release 빌드 간 결과가 동일하게 나오는 문제가 있었다. 원인은 VSCode의 cmake.configureArgs에 CMAKE_BUILD_TYPE이 명시되지 않아 CMake Presets의 Release 설정이 실제로 적용되지 않았기 때문이다. 또한 CubeProgrammer가 이전에 지정된 Debug 빌드 경로의 .elf를 그대로 업로드하고 있어, 설정과 무관하게 항상 같은 바이너리가 실행되고 있었다.

⚠ 해결

• settings.json의 cmake.configureArgs에 "-DCMAKE_BUILD_TYPE=Release" 명시적으로 추가

• CMake: Delete Cache and Reconfigure 실행

• CubeProgrammer 업로드 경로를 build/Release/*.elf로 명시적으로 재지정

• 검증: Debug .elf와 Release .elf의 파일 크기를 비교해 Release가 약 1/10 크기임을 확인 → 최적화 적용 확정

## 2.2 측정 조건

항목 | 값
코어 클럭 | 84MHz
반복 횟수 | 각 측정당 100회 (축2는 5개 입력값 × 100회 = 500회)
집계 방식 | 총 사이클 합산 후 평균
빌드 타입 | Release (-O2 계열, 파일 크기 기준 확인)
측정 위치 | main() 초기화 직후, while(1) 진입 전 1회 실행

# 3. 축1 — 추상화 비용 (HAL vs 베어메탈)

## 3.1 GPIO

Motor_Forward() (HAL_GPIO_WritePin 3회 호출) vs Motor_Forward_Bare() (GPIOC->BSRR 직접 대입 3회)를 비교했다.

측정 코드 (main() 초기화 직후, while(1) 진입 전 1회 실행):

uint32_t cycles_hal = 0, cycles_bare = 0;

for (int i = 0; i < 100; i++) {

uint32_t s = DWT_GetCycles();

Motor_Forward();

uint32_t e = DWT_GetCycles();

cycles_hal += (e - s);

}

for (int i = 0; i < 100; i++) {

uint32_t s = DWT_GetCycles();

Motor_Forward_Bare();

uint32_t e = DWT_GetCycles();

cycles_bare += (e - s);

}

printf("HAL avg: %lu cycles\r\n", cycles_hal / 100);

printf("Bare avg: %lu cycles\r\n", cycles_bare / 100);

빌드 | HAL (cycles) | 베어메탈 (cycles) | 배율
Debug | 150 | 47 | 3.2배
Release | 48 | 14 | 3.4배

Release 환산 시간: HAL 약 0.57μs, 베어메탈 약 0.17μs (84MHz 기준). 최적화를 적용해도 배율이 거의 유지됐다. 당초 이 차이의 원인을 "매개변수 검사·조건 분기"로 추정했으나, 이는 실제 HAL 소스코드 검증 없이 내린 결론이었다. 3.1.1절에서 실제 소스 분석으로 이 추정을 검증·정정한다.

3.1.1 [보강] HAL_GPIO_WritePin() 실제 소스 분석

이전 절(3.1)의 원인 설명은 HAL 소스코드를 직접 확인하지 않은 추정이었다. 실제 stm32f4xx_hal_gpio.c와 stm32f4xx_hal_conf.h를 확인해 원인을 재검증했다.

void HAL_GPIO_WritePin(GPIO_TypeDef* GPIOx, uint16_t GPIO_Pin, GPIO_PinState PinState)

{

assert_param(IS_GPIO_PIN(GPIO_Pin));

assert_param(IS_GPIO_PIN_ACTION(PinState));

if(PinState != GPIO_PIN_RESET)

{

GPIOx->BSRR = GPIO_Pin;

}

else

{

GPIOx->BSRR = (uint32_t)GPIO_Pin << 16U;

}

}

stm32f4xx_hal_conf.h(템플릿 기준)에서 USE_FULL_ASSERT 정의 여부를 확인한 결과:

/* #define USE_FULL_ASSERT 1U */ // 주석 처리 — 기본 비활성

#ifdef USE_FULL_ASSERT

#define assert_param(expr) ((expr) ? (void)0U : assert_failed(...))

#else

#define assert_param(expr) ((void)0U) // 비활성 시 완전히 무의미한 코드로 치환

#endif

⚠ 정정된 결론

• USE_FULL_ASSERT가 비활성(기본값)이라면 assert_param 2회 호출은 컴파일러에 의해 완전히 제거되어 실행 코드에 남지 않는다.

• 따라서 "매개변수 검사 비용"이라는 이전 설명은 부정확하다.

• 실제 남는 오버헤드 후보는 (1) 함수가 인라인되지 않을 경우의 호출/복귀 비용, (2) if-else 조건 분기 1회, 이 두 가지뿐이다.

• 본 프로젝트의 실제 stm32f4xx_hal_conf.h(USE_FULL_ASSERT 설정)와 컴파일된 어셈블리(디스어셈블리)까지 확인해야 100% 확정할 수 있으며, 이는 검증되지 않은 잔여 가정으로 남는다.

✓ 교훈

• 성능 차이를 "실측"했다고 해서 그 "원인"까지 실측한 것은 아니다 — 실행 시간 측정(블랙박스)과 소스코드 분석(화이트박스)은 별개의 검증이다.

• 이번 정정을 통해 보고서의 인과 관계 서술을 추정에서 실제 소스 근거로 격상시켰다.

## 3.2 PWM

Motor_SetSpeed() (__HAL_TIM_SET_COMPARE 매크로) vs Motor_SetSpeed_Bare() (TIM3->CCR1 직접 대입)를 비교했다.

uint32_t cycles_pwm_hal = 0, cycles_pwm_bare = 0;

for (int i = 0; i < 100; i++) {

uint32_t s = DWT_GetCycles();

Motor_SetSpeed(500);

uint32_t e = DWT_GetCycles();

cycles_pwm_hal += (e - s);

}

for (int i = 0; i < 100; i++) {

uint32_t s = DWT_GetCycles();

Motor_SetSpeed_Bare(500);

uint32_t e = DWT_GetCycles();

cycles_pwm_bare += (e - s);

}

printf("PWM HAL avg: %lu cycles\r\n", cycles_pwm_hal / 100);

printf("PWM Bare avg: %lu cycles\r\n", cycles_pwm_bare / 100);

빌드 | HAL (cycles) | 베어메탈 (cycles) | 비고
Release | 4 | 5 | 차이 없음 (측정 노이즈 수준)

✓ 핵심 발견

• __HAL_TIM_SET_COMPARE()는 함수가 아니라 매크로로 구현되어 있어, 전처리 단계에서 베어메탈과 동일한 레지스터 대입 코드로 치환된다.

• 따라서 "HAL이 느리다"는 일반화는 부정확하다 — HAL 내부에서도 구현 방식(함수 기반 vs 매크로 기반)에 따라 오버헤드가 크게 갈린다.

# 4. 축2 — 수치 표현 (나눗셈 vs 양자화)

## 4.1 배경

당초 float 연산과 정수 연산을 비교할 계획이었으나, 프로젝트 코드에 float 연산이 존재하지 않아 서사적으로 약하다고 판단해 방향을 변경했다. 대신 실제 코드(ADC_ToDuty)에 존재하는 나눗셈 연산을 고정소수점 양자화(곱셈+시프트)로 대체하는 최적화를 적용하고 그 효과를 측정했다.

## 4.2 구현

// 기존: 나눗셈

uint16_t ADC_ToDuty(uint16_t adcValue){

if (adcValue>4095) adcValue=4095;

return (uint16_t)((uint32_t)adcValue*999/4095);

}

// 개선: Q16 고정소수점 양자화

uint16_t ADC_ToDuty_Quantized(uint16_t adcValue){

if (adcValue > 4095) adcValue = 4095;

const uint32_t SCALE_Q16 = 15984; // (999*65536)/4095 을 미리 계산

uint16_t duty = (uint16_t)(((uint32_t)adcValue * SCALE_Q16) >> 16);

if (duty > 999) duty = 999; // 양자화 반올림 오차로 인한 상한 초과 방어

return duty;

}

측정 코드 (더미 입력값 5개 × 100회 = 500회 반복):

uint32_t cycles_div = 0, cycles_quant = 0;

uint16_t dummy_inputs[5] = {0, 1000, 2048, 3000, 4095};

for (int i = 0; i < 100; i++) {

for (int j = 0; j < 5; j++) {

uint32_t s = DWT_GetCycles();

volatile uint16_t r = ADC_ToDuty(dummy_inputs[j]);

uint32_t e = DWT_GetCycles();

cycles_div += (e - s);

}

}

for (int i = 0; i < 100; i++) {

for (int j = 0; j < 5; j++) {

uint32_t s = DWT_GetCycles();

volatile uint16_t r = ADC_ToDuty_Quantized(dummy_inputs[j]);

uint32_t e = DWT_GetCycles();

cycles_quant += (e - s);

}

}

printf("Div avg: %lu cycles\r\n", cycles_div / 500);

printf("Quant avg: %lu cycles\r\n", cycles_quant / 500);

// 오차 검증 (0~4095 전수 비교)

int16_t max_error = 0;

for (uint32_t v = 0; v <= 4095; v++) {

int16_t diff = (int16_t)ADC_ToDuty((uint16_t)v)

- (int16_t)ADC_ToDuty_Quantized((uint16_t)v);

if (diff < 0) diff = -diff;

if (diff > max_error) max_error = diff;

}

printf("Max error: %d\r\n", max_error);

## 4.3 측정 결과

항목 | 나눗셈 방식 | 양자화 방식 | 차이
평균 사이클 (Release, 500회) | 15 cycles | 9 cycles | 1.67배 빠름
환산 시간 (84MHz 기준) | 0.179μs | 0.107μs | 약 0.07μs 단축
최대 오차 (0~4095 전수 비교) | - | - | ±1 (듀티 0~999 기준)

✓ 결론

• 양자화 적용으로 계산 속도 약 40% 단축 (15→9 cycles)

• 정확도 손실은 최대 ±1 (오차율 약 0.1%)로, PWM 듀티 제어 목적상 실질적으로 무시 가능한 수준

• 양자화 결과가 상한(999)을 초과할 가능성에 대비해 방어 로직을 추가했으며, 방어 로직 추가 후에도 오차 검증 결과는 동일하게 유지됨을 확인

# 5. 축3 — 필터 (원시 ADC 값 vs 이동평균)

## 5.1 배경

가변저항 정지 상태에서 ADC 값이 ±1~2 수준으로 흔들리는 노이즈를 Phase 1-5에서 확인한 바 있다. 이 노이즈를 8-샘플 이동평균 필터로 얼마나 줄일 수 있는지, 그리고 그 대가로 계산 비용이 얼마나 늘어나는지를 실측했다.

## 5.2 구현

#define FILTER_SIZE 8

uint16_t filterBuf[FILTER_SIZE] = {0};

uint8_t filterIdx = 0;

uint16_t ADC_MovingAverage(uint16_t newValue){

filterBuf[filterIdx] = newValue;

filterIdx = (filterIdx + 1) % FILTER_SIZE;

uint32_t sum = 0;

for (int i = 0; i < FILTER_SIZE; i++) sum += filterBuf[i];

return (uint16_t)(sum / FILTER_SIZE);

}

## 5.3 측정 결과

항목 | 원시 ADC (raw) | 이동평균 필터 (filtered)
평균 사이클 (100회) | 62 cycles | 83 cycles (+34%)
표준편차 (가변저항 중간값 고정) | 1.139 | 0.5 (약 56% 감소)
값 흔들림 범위 | 7 (2266~2273) | 1 (2268~2269)

⚠ 관찰된 특이 현상 — 필터 워밍업 구간

• 측정 시작 직후 filtered 값이 283, 567, 850처럼 비정상적으로 낮게 나오는 구간이 있었다.

• 원인은 filterBuf가 0으로 초기화된 상태에서 버퍼 8칸이 다 채워지기 전까지는 "0과 실제값이 섞인 평균"이 출력되기 때문이다.

• 버퍼가 다 채워진 이후(약 8회차 이후)부터는 정상적인 필터링 값으로 안정됐다 — 실사용 시 초기 워밍업 구간을 감안하거나 버퍼를 첫 실측값으로 미리 채워두는 보완이 필요하다.

✓ 결론

• 34%의 사이클 비용 증가로 노이즈(표준편차)를 약 56% 감소시켰고, 값 흔들림 범위는 7에서 1로 좁혔다.

보강(2026-10-25): 노이즈 수치(표준편차, 흔들림 범위)는 ADC 클럭이 42MHz로 DS10693 상한 36MHz를 넘은 상태(ADCPRE 미설정)에서 잰 값이다(Phase 1-5 3.1 보강, 외부평가 A7). 필터의 사이클 비용은 ADC 클럭과 무관하다. 노이즈는 Phase 3.7 작업 10의 클럭 수정 뒤 Phase 2.5 작업 1에서 다시 잰다.

재검토(2026-10-25): 측정 당시에도 ADCPRE를 설정하는 코드가 없었다는 근거는 Phase 1-5 보고서 3.1절 재검토 문단과 같다(MX_ADC1_Init() 미호출, ADC1_Init_Bare()는 ADC_CCR을 건드리지 않음).

• 실시간 제어 루프에서 이 정도 사이클 비용 증가는 미미하며(수십 사이클 단위), 노이즈 감소 효과가 이를 상회하는 유리한 트레이드오프다.

# 6. 종합 결론

항목 | 결과 | 해석
GPIO (함수 기반 HAL) | 베어메탈이 3.4배 빠름 | ~~함수 호출의 매개변수 검사·분기 비용이 실측으로 확인됨~~ 정정(2026-10-25): 실행 시간 차이(3.4배)는 실측했지만 원인은 실측하지 않았다. 3.1.1절 소스 분석상 남는 후보는 함수 호출·복귀 비용과 조건 분기 1회이며, 디스어셈블리 확인은 Phase 2.5에서 한다. 재검토(2026-10-25): 3.4배 자체도 DWT 오버헤드(18 cycles)를 빼지 않은 값이라 비율의 정의가 불분명하다(외부평가 C1). 2.5 작업 1에서 보정해 다시 잰다.
PWM (매크로 기반 HAL) | 차이 없음 | 매크로는 전처리 단계에서 동일 코드로 치환되어 오버헤드 없음
나눗셈 vs 양자화 | 양자화가 1.67배 빠름 | 오차 0.1% 수준으로 실용적 트레이드오프 확인
원시값 vs 이동평균 필터 | 필터가 34% 더 느림 | 대신 노이즈 표준편차 약 56% 감소 — 유리한 트레이드오프

세 축 모두에서 공통된 결론은, "더 빠른 것"이나 "더 정교한 것"을 무조건 택하는 게 아니라 각 트레이드오프를 실측으로 정량화한 뒤 목적에 맞게 선택했다는 것이다. HAL vs 베어메탈은 추상화 방식(함수 vs 매크로)에 따라 다른 결론이 나왔고, 나눗셈 vs 양자화는 속도를 얻는 대신 미미한 오차를 감수했으며, 원시값 vs 필터는 속도를 내주는 대신 노이즈를 크게 줄였다. Phase 2는 이것으로 완료한다.
