rkalsdud/MARCO/보고서/MARCO_Phase3_결과보고서.docx

MARCO 프로젝트

Motor And Real-time Control Over CAN

Phase 3 결과 보고서 — CAN1↔CAN2 게이트웨이

2026년 7월 27일 완료

정정(2026-10-25): 게이트웨이 원인 해석(외부 평가 B1), 0x789 전달 판정(B2), 과장 표현을 정정했다. 틀린 문장은 지우지 않고 취소선으로 남겼고, 바로 아래에 정정 문단을 붙였다. 원인 정정의 원본은 트러블슈팅 로그 ISSUE 022 "정정 이력" 절이다.

보강(2026-10-26): 8.5절 배선 요약 표 아래에 종단저항 120Ω × 2의 실장 위치(트랜시버 모듈 기판)와 실측값을 보강했다.

본 보고서는 게이트웨이 개념 검증(MVP)을 완료한 최종 결과다. 물리적으로 완전히 분리된 두 버스 + 별도 노드 구성, HIL 테스트는 Phase 5(라즈베리파이/SocketCAN 결합) 단계로 이관한다.

최종 반영: CAN1 수신 핸들러 반영 완료, CAN2 핸들러의 RDHR/TDHR 누락(DLC 5바이트 이상 시 상위 데이터 유실 가능) 보완 완료. ~~양방향 게이트웨이가 무한루프 없이 안정 상태로 반복 동작함을 최종 확인했다.~~

정정(2026-10-25): 무한루프 없이 안정 상태가 된 것은 맞다. 다만 이 배선(버스 하나)에서는 각 컨트롤러가 상대가 보낸 프레임을 버스에서 직접 받고, 게이트웨이 전달 코드는 실행되지 않는다(코드 추적 기준). 양방향 전달은 두 버스를 분리한 뒤 검증한다.

# 1. 개요

✓ 작업 요약

• CAN1(버스A)/CAN2(버스B)를 각각 베어메탈로 초기화하고 필터 뱅크 분배(CANSB)로 두 컨트롤러를 공존시켰다.

• 게이트웨이 무한루프를 실측으로 겪고, ID 대역 기반 라우팅 규칙으로 해결했다.

• ~~제3의 메시지가 실제로 반대편 버스까지 전달되는 것을 검증하고,~~ DBC 파일을 설계해 CANdb++로 이중 검증했다.

정정(2026-10-25): 0x789는 같은 버스에서 CAN2가 직접 받은 것이라 게이트웨이 전달의 증거가 아니다(3.4절 정정).

## 1.1 목적

보드 1개에 내장된 CAN1, CAN2 두 컨트롤러를 각각 다른 트랜시버로 연결해, 두 버스를 다리 놓는 게이트웨이의 최소 기능을 구현하고 검증한다. Phase 1-7의 CAN1 루프백이 레지스터 레벨(소프트웨어 내부) 검증이었다면, ~~이번 단계는 실제 트랜시버·전선을 거친 물리 계층 검증이라는 데 차이가 있다.~~

정정(2026-10-25): 실제 트랜시버와 전선을 거친 것은 맞지만, 같은 칩·같은 클럭·같은 버스 위의 시험이라 물리 계층 전체를 검증했다고 볼 수 없다. 트랜시버를 거친 송수신을 확인한 단계로 한정한다.

## 1.2 아키텍처

STM32F446RE는 CAN1, CAN2 두 개의 독립된 CAN 컨트롤러를 내장하고 있다. 두 컨트롤러는 필터 뱅크(총 28개)를 나눠 쓰는 구조로 연결되어 있어, CAN2를 쓰려면 CAN1의 클럭도 함께 켜져 있어야 한다.

구성 요소 | 역할
CAN1 컨트롤러 | 버스A 담당, PB8(RX)/PB9(TX), AF9
CAN2 컨트롤러 | 버스B 담당, PB5(RX)/PB6(TX), AF9
트랜시버 1, 2 | SN65HVD230, 각각 CAN1/CAN2에 연결
필터 뱅크 분배 | CANSB=1 설정 → 뱅크0=CAN1, 뱅크1=CAN2
게이트웨이 로직 | 각 컨트롤러의 수신 인터럽트 핸들러에서 반대편으로 재전송

## 1.3 현재 검증 배선

최종 목표(서로 완전히 독립된 두 버스, 각 버스에 별도 노드 존재)로 가기 전 단계로, 지금은 트랜시버1과 트랜시버2의 CANH-CANH, CANL-CANL을 점퍼선으로 직결해 물리 계층 자체가 정상 동작하는지만 검증하는 최소 배선을 사용했다. 이 구성에서는 버스가 물리적으로 하나이며, 우리 보드가 사실상 자기 자신과 게이트웨이를 거쳐 통신하는 상태다.

# 2. 구현 — 데이터시트 대조 및 계산 근거

## 2.1 CAN2 레지스터 확인

레지스터 | 필드 | 값 | 확인
DS10693 | PB5/PB6 = CAN2_RX/TX | AF9 | ✅
RCC APB1ENR | CAN2EN | 비트26 | ✅
CAN_FMR | CANSB (필터뱅크 분배 시작점) | 비트[13:8] | ✅
CAN_FMR | FINIT (필터 설정 모드) | 비트0 | ✅ (CAN1과 동일 재확인)

BRP=5(분주비6), TS1=10(11TQ), TS2=1(2TQ), SJW=0(1TQ) 값은 Phase 1-7 2.3절에서 산출한 CAN1과 동일한 500kbps 근사 통신속도 설정을 CAN2에도 그대로 재사용했다. 같은 버스 규격을 맞추기 위한 의도적 선택이다.

## 2.2 필터 뱅크 분배

CAN1->FMR |= (1<<0); // FINIT=1

CAN1->FMR &= ~(0x3F << 8); // CANSB 클리어

CAN1->FMR |= (1 << 8); // CANSB=1

// 결과: 필터 뱅크 0 = CAN1 소유, 필터 뱅크 1~27 = CAN2 소유

// CAN2는 sFilterRegister[1]을 사용

# 3. 검증

## 3.1 초기 시도 — 무한루프 발생 (ISSUE 022)

트랜시버 배선 직후 게이트웨이 로직(무조건 반대편 재전송)을 처음 시도했을 때, CAN1과 CAN2가 ~~서로의 송신을 재수신하며~~ 무한히 반복 전송하는 루프가 실측으로 발생했다. 상세 진단 과정은 트러블슈팅 로그 ISSUE 022를 참조한다.

정정(2026-10-25): 같은 버스에 있는 두 컨트롤러가 상대가 보낸 프레임을 받아 조건 없이 다시 보내는 핑퐁이었다. 컨트롤러가 자기 송신을 다시 받은 것이 아니다.

## 3.2 ID 기반 루프 방지 적용

void CAN1_RX0_IRQHandler(void){

if (CAN1->RF0R & 0x3){

uint32_t rxId = (CAN1->sFIFOMailBox[0].RIR >> 21) & 0x7FF;

uint32_t data0 = CAN1->sFIFOMailBox[0].RDLR;

uint32_t data1 = CAN1->sFIFOMailBox[0].RDHR;

if (rxId != 0x456 && (CAN2->TSR & (1<<26))){

CAN2->sTxMailBox[0].TIR = (0x123<<21);

CAN2->sTxMailBox[0].TDTR = 8;

CAN2->sTxMailBox[0].TDLR = data0;

CAN2->sTxMailBox[0].TDHR = data1;

CAN2->sTxMailBox[0].TIR |= (1<<0);

}

printf("CAN1 RX: id=%lx data0=%lx\r\n", rxId, data0);

CAN1->RF0R |= (1<<5);

}

}

// CAN2_RX0_IRQHandler도 대칭 구조 (0x123/0x456 역할만 반대)

## 3.3 최종 관찰 결과

CAN1 RX: id=456 data0=ddccbbaa

CAN2 RX: id=123 data0=44332211

CAN1 RX: id=456 data0=ddccbbaa

CAN2 RX: id=123 data0=44332211

CAN1 RX: id=456 data0=ddccbbaa

✓ 검증 결과 (1차)

• 물리 계층: 트랜시버·전선을 거친 데이터가 손실·변형 없이 정확히 전달됨

• 필터 공유(CANSB): CAN1/CAN2가 필터 뱅크를 나눠 쓰면서도 각자 독립적으로 정상 수신

• 루프 방지: ID 기반 필터링으로 무한루프 없이 안정 상태(steady state) 도달

보충(2026-10-25): 루프가 멈춘 것은 맞다. 이 배선에서 ID 대역 조건은 전달 자체를 일어나지 않게 만들어 루프를 멈췄다(트러블슈팅 로그 ISSUE 022 정정 이력).

## 3.4 신규 메시지 실제 전달 검증

1차 검증은 CAN1/CAN2가 각자의 원본 메시지를 서로 "차단"하는 동작 위주였다. "제3의 메시지가 실제로 반대편까지 전달되는가"를 확인하기 위해, CAN1이 5회 송신마다 1회 새로운 ID(0x789)를 섞어 보내도록 확장했다.

static int counter = 0; counter++;

uint32_t sendId = (counter % 5 == 0) ? 0x789 : 0x123;

CAN1->sTxMailBox[0].TIR = (sendId << 21);

// ... 이하 동일하게 송신

이 확장 직후 ISSUE 024(루프 방지 필터 구멍)가 재현됐다. CAN2의 필터 조건이 rxId != 0x123 하나만 검사하고 있어 0x789를 걸러내지 못하고 그대로 되돌려보냈기 때문이다. ID 대역을 매크로로 캡슐화해 해결했다 (상세는 트러블슈팅 로그 ISSUE 024 참조).

#define IS_BUS_A_ID(id) ((id) == 0x123 || (id) == 0x789)

#define IS_BUS_B_ID(id) ((id) == 0x456)

CAN2 RX: id=123 data0=44332211

CAN1 RX: id=456 data0=ddccbbaa

CAN1 RX: id=123 data0=ddccbbaa

CAN2 RX: id=456 data0=44332211

CAN2 RX: id=789 data0=44332211 <- NEW MSG FORWARDED CHECK

CAN1 RX: id=456 data0=ddccbbaa

CAN1 RX: id=123 data0=ddccbbaa

CAN2 RX: id=456 data0=44332211

✓ 검증 결과 (2차)

• ~~0x789 신규 메시지가 정확히 5회 송신 중 1회 꼴로 CAN2에 전달됨을 확인 (NEW MSG FORWARDED CHECK 태그)~~

정정(2026-10-25): 단일 버스에서는 CAN2가 0x789를 CAN1에서 버스로 직접 받는다. 이 태그는 게이트웨이 전달의 증거가 아니다. 실제 전달 검증은 두 버스를 분리한 뒤로 미룬다.

• ID 대역 기반 매크로(IS_BUS_A_ID/IS_BUS_B_ID) 적용 후 루프 없이 안정 유지

## 3.5 비동기 동작 관찰

CAN1과 CAN2는 별도의 레지스터 세트와 별도의 인터럽트 벡터를 가진 완전히 독립된 하드웨어로, 공통 클럭이나 동기화 신호 없이 각자의 타이밍대로 동작한다. 로그 상에서 CAN1/CAN2 수신 순서가 매 사이클 미세하게 달라지는 것은 이 비동기적 특성에 따른 정상 현상이다. 다만 완전한 무작위는 아니며, 두 컨트롤러가 상호 하트비트를 주고받는 4줄 단위의 안정된 패턴이 매 초 반복되는 형태로 관찰됐다.

⚠ 현재 검증의 한계

• 현재 배선은 두 트랜시버를 직결한 단일 버스 구성으로, 서로 완전히 독립된 두 버스 및 별도 노드가 존재하는 최종 목표 구성과는 다르다.

• ID 대역 판정은 여전히 매크로 안에 개별 ID를 나열하는 방식이다 — 노드가 늘어나면 범위 비교(부등호) 또는 하드웨어 필터로 전환이 필요하다.

# 4. 트러블슈팅 요약

번호 | 제목 | 핵심 원인 | 상태
020 | CAN2 PUPDR 설정 오류 | ~ 연산자 누락 (ISSUE 013과 동일 패턴) | 해결 ✅
021 | CAN2가 전혀 동작 안 함 | CAN2_Init_Bare() 호출 누락 | 해결 ✅
022 | 게이트웨이 무한루프 발생 | 무조건적인 반대편 재전송 | 해결 ✅
023 | 수정 사항 미반영처럼 보임 | 이전 빌드의 잔존 코드 | 해결 ✅
024 | 루프 방지 필터에 구멍 발생 | 단일 ID 비교로는 확장된 ID 대응 불가 | 해결 ✅

# 5. 설계 개념 정리

## 5.1 노드와 게이트웨이

게이트웨이는 노드의 특수한 경우다 — 두 개 이상의 버스에 동시에 연결되어 메시지를 중계하는 노드를 게이트웨이라 부른다. 우리 메인보드는 CAN 컨트롤러 2개를 가진 덕분에, 버스A 입장에서는 노드 하나, 버스B 입장에서도 노드 하나이면서 동시에 그 둘을 잇는 게이트웨이 역할을 겸한다.

## 5.2 무한루프의 근본 원인

~~CAN 컨트롤러는 자신이 버스에 송신한 프레임을 스스로도 재수신하는 특성이 있다(에러 검출 메커니즘의 일부). 게이트웨이가 수신한 메시지를 조건 없이 반대편으로 재전송하면, 이 자기 재수신 특성과 맞물려 두 버스가 물리적으로 분리되어 있어도 무한루프가 발생할 수 있다.~~

정정(2026-10-25): 이 절은 틀린 전제 위에 있다. RM0390 Rev 9에서 자기 송신을 수신 메일박스에 저장하는 동작은 루프백 모드(30.5.2, 1023쪽)의 동작으로만 기술되고 Normal 모드(30.4.2, 1021쪽)에는 없다. 무한루프의 원인은 같은 버스 위 두 컨트롤러의 상호 재전송(핑퐁)이었고, 버스를 분리하면 게이트웨이는 자기가 전달한 프레임을 받지 않으므로 이 루프는 생기지 않는다. 상세는 트러블슈팅 로그 ISSUE 022 정정 이력.

## 5.3 ID 기반 루프 방지와 아비트레이션의 관계

두 개념은 서로 무관하다. 아비트레이션은 같은 버스를 공유하는 여러 노드가 동시에 송신을 시도할 때 우선순위를 정하는 메커니즘이며, 버스에 노드가 2개 이상 있을 때만 의미가 있다. ~~반면 ID 기반 루프 방지는 게이트웨이 한 대가 자신의 재전송을 자신이 다시 수신하는 것을 막는 것으로, 노드 경쟁과는 다른 문제다. 따라서 이 해결책은 두 번째 메인보드 없이도 (보드 1개로) 그대로 적용할 수 있다.~~

정정(2026-10-25): ID 대역 판별은 같은 버스 위 두 컨트롤러의 핑퐁을 막는 장치로 동작했다. 버스를 분리한 뒤에는 루프 방지가 아니라 어느 프레임을 어느 버스로 넘길지 정하는 라우팅 규칙이 된다. 아비트레이션과 무관하다는 첫 두 문장은 그대로 맞다.

# 6. 결론 및 다음 단계

CAN1↔CAN2 게이트웨이의 최소 기능 프로토타입이 ~~물리 계층까지 포함해 검증됐다~~. ~~신규 메시지 전달과~~ ID 대역 매크로화까지 완료해, 개념 검증(MVP) 단계는 사실상 마무리됐다. 다음 단계는 이 프로토타입을 정식 설계로 확장하는 것이다.

정정(2026-10-25): 같은 칩·같은 버스 위의 시험이라 "물리 계층까지 포함해 검증"은 과장이다. 0x789 전달은 게이트웨이 전달이 아니었다(3.4절 정정). 개념 검증 범위는 ID 대역 루프 방지와 매크로화, DBC 반영까지로 한정한다.

✓ 완료된 항목

• 물리 계층/필터 공유/루프 방지 1차 검증

• ~~제3의 메시지(0x789) 실제 전달 검증~~

정정(2026-10-25): 게이트웨이 전달이 아니었다(3.4절 정정).

• ID 대역 매크로화 (IS_BUS_A_ID / IS_BUS_B_ID)

순서 | 작업
1 | DBC 파일 설계 착수 — 메시지/신호 목록 정리, ID 대역(버스A용/버스B용) 확정
2 | ID 대역 매크로를 부등호 기반 범위 비교로 확장 (노드 다수 대응)
3 | 두 버스를 완전히 분리하고 각 버스에 최소 1개 이상의 추가 노드를 연결해 진짜 2-버스 구성으로 확장
4 | 필요 시 하드웨어 필터 뱅크로 루프 방지 로직을 이전해 CPU 부하 경감
5 | CAN 메시지 → 모터 제어 통합 (Phase 3.5, 로드맵에 신규 추가된 항목)
6 | HIL(Hardware-in-the-Loop) 테스트 시나리오 설계

7. 최종 마무리

Phase 3의 남은 항목(물리적으로 완전히 분리된 두 버스 + 별도 노드, HIL 테스트)은 현재 보유 하드웨어(보드 1개)로는 실질적 검증 내용이 늘어나지 않는다고 판단해, 라즈베리파이4 + MCP2515 SocketCAN 노드가 결합되는 Phase 5로 이관하기로 했다. Phase 3는 게이트웨이 개념 검증(MVP)과 DBC 반영까지를 목표로 완결한다.

7.1 최종 보완 — CAN2 핸들러 RDHR/TDHR 누락

CAN1_RX0_IRQHandler는 RDHR(data1)까지 읽어 전달했으나, CAN2_RX0_IRQHandler는 RDLR(data0)만 읽고 전달하고 있었다. 지금까지 CAN2가 처리하던 메시지(MotorCommand DLC=3, ControlHeartbeat DLC=1)는 4바이트 이내라 문제가 드러나지 않았지만, DLC 5바이트 이상인 메시지(예: EncoderCount)를 CAN2가 CAN1로 전달할 경우 상위 4바이트가 유실될 잠재적 결함이었다. data1(RDHR)을 읽어 TDHR에 채우도록 보완했다.

7.2 최종 검증 로그

DBC 확정 ID를 실제 코드에 반영하고, CAN1/CAN2 수신 핸들러를 대칭적으로 완성한 뒤 무한루프 없이 안정적으로 반복되는 것을 확인했다.

MotorCommand: dir=1 duty=750

MonitorHeartBeat: 1

MotorCommand: dir=1 duty=750

MonitorHeartBeat: 2

MotorCommand: dir=1 duty=750

MonitorHeartBeat: 3

MotorCommand: dir=1 duty=750

MonitorHeartBeat: 4

ControlHeartbeat: 5

MonitorHeartBeat: 5

MotorCommand: dir=1 duty=750

MonitorHeartBeat: 6

작업 요약

• ~~CAN1→CAN2, CAN2→CAN1 양방향 모두 정상 파싱 및 출력~~

정정(2026-10-25): 두 방향 모두 수신·파싱된 것은 맞지만, 같은 버스에서 각 컨트롤러가 상대의 송신을 직접 받은 것이다. 게이트웨이 전달을 거친 출력이 아니다(3.4절 정정).

• ControlHeartbeat이 5회에 1회 정상 수신 — while(1)의 카운터 스케줄링과 CAN 필터링이 정확히 맞물림

• 1초 간격(HAL_Delay) 주기에 맞춰 로그가 출력 — 무한루프 재발 없음

7.3 Phase 3 완료 판정 및 Phase 5 이관 항목

항목 | 판정
CAN1/CAN2 게이트웨이 구현 | ~~완료~~ 정정(2026-10-25): 전달 코드 작성까지 완료. 현재 배선에서는 전달 본문이 실행되지 않아 동작은 미검증이며, 두 버스 분리 후 검증한다(Phase 5). 재검토(2026-10-25): ISSUE 022·024 당시에는 그때 코드의 재전송이 실제로 실행됐다(핑퐁). 검증되지 않은 것은 분리된 두 버스 사이의 전달이다.
ID 대역 기반 루프 방지 | 완료
DBC 설계 및 코드 반영 | 완료
양방향 안정 동작 검증 | ~~완료~~ 정정(2026-10-25): 무한루프 없이 안정 반복하는 것은 확인. 양방향 전달 검증은 아니며(단일 버스 직접 수신), 두 버스 분리 후 검증한다(Phase 5).
완전 분리된 물리적 두 버스 + 별도 노드 | Phase 5로 이관
HIL 테스트 | Phase 5 이후로 이관

8. Phase 3.5 — CAN 명령과 모터 제어 통합

DBC로 설계한 MotorCommand 메시지를 실제로 수신해 모터를 구동하고, 가변저항 값을 실시간으로 CAN 메시지에 실어 보내는 전체 체인(가변저항 → ADC → CAN1 → 물리 버스 → CAN2 → 모터)을 완성했다.

8.1 데이터 흐름

가변저항의 아날로그 전압이 ADC로 디지털화되어 CAN1에서 MotorCommand 메시지로 만들어지고, 물리적 CAN 버스(트랜시버1→전선→트랜시버2)를 거쳐 CAN2가 수신·해석한 뒤 모터 제어 함수를 통해 실제 모터가 회전한다.

가변저항 --> ADC(PC3) --> CAN1 송신(MotorCommand)

--> 물리적 버스(트랜시버1-트랜시버2) --> CAN2 수신/파싱

--> Motor_*_Bare() --> TB6612FNG --> 모터 회전

8.2 구현 — CAN2 수신 핸들러 확장

if (rxId==ID_MOTOR_COMMAND){

uint8_t direction = data0 & 0xFF;

uint16_t targetDuty = (data0 >> 8) & 0xFFFF;

printf("MotorCommand: dir=%d duty=%d\r\n", direction, targetDuty);

switch (direction) {

case DIR_FORWARD:

Motor_Forward_Bare();

Motor_SetSpeed_Bare(targetDuty);

break;

case DIR_REVERSE:

Motor_Backward_Bare();

Motor_SetSpeed_Bare(targetDuty);

break;

case DIR_STOP:

default:

Motor_Stop_Bare();

break;

}

}

8.3 구현 — CAN1 송신부, 가변저항 실시간 반영

if (counter % 5 != 0) {

uint16_t adcValue = ADC_Read_Bare();

uint16_t targetDuty = ADC_ToDuty(adcValue); // 고정값 750 -> 실시간 변환

uint8_t direction = DIR_FORWARD;

CAN1->sTxMailBox[0].TIR = (ID_MOTOR_COMMAND << 21);

CAN1->sTxMailBox[0].TDTR = 3;

CAN1->sTxMailBox[0].TDLR = direction | ((uint32_t)targetDuty << 8);

CAN1->sTxMailBox[0].TIR |= (1<<0);

}

8.4 검증 결과

가변저항을 최소~최대까지 돌리는 동안 CAN을 거쳐 모터 duty가 실시간으로 추종하는 것을 확인했다.

MotorCommand: dir=1 duty=556

MotorCommand: dir=1 duty=753

MotorCommand: dir=1 duty=951

MotorCommand: dir=1 duty=998 (최대)

MotorCommand: dir=1 duty=490

MotorCommand: dir=1 duty=155

MotorCommand: dir=1 duty=0 (최소)

작업 요약

• 가변저항 회전에 따라 duty가 0~998까지 부드럽게 추종하는 것을 실측 확인했다.

• 정지 근처(duty 0)에서 0~7 사이의 미세한 흔들림이 관측됐다 — Phase 1-5/2에서 이미 확인한 ADC 노이즈(±1~2) 특성이 CAN을 거쳐서도 그대로 나타난 것으로, 모터 동작에 육안상 지장은 없다.

• 무한루프 없이 MotorCommand/ControlHeartbeat/MonitorHeartBeat이 안정적으로 반복됨을 재확인했다.

8.5 배선 요약

구성 | 연결
엔코더 파랑/노랑 | 3.3V / GND (극성 고정, 노랑은 STM32 GND 핀 직결 권장)
엔코더 초록 | PA0 (TIM2_CH1, 유효 신호선)
엔코더 하양 | 미사용 (연결 안 함)
가변저항 와이퍼 | PC3 (ADC1_IN13)
트랜시버1 / 트랜시버2 | PB8·PB9(CAN1) / PB5·PB6(CAN2)
종단저항 120Ω ×2 | 각 트랜시버의 CANH-CANL 사이

보강(2026-10-26): 120Ω 두 개는 따로 단 저항이 아니라 두 SN65HVD230 모듈 기판에 실장된 칩저항(표기 121)이다. 전원을 끈 상태에서 모듈별 CANH–CANL 약 120Ω, 두 모듈을 이은 버스 약 60Ω으로 측정했다(멀티미터, 2026-10-26). 외부 종단저항은 달지 않았다. (Claude 작성, 외부 검토 전)

9. Phase 3 / 3.5 최종 결론

완료 항목

• CAN1/CAN2 게이트웨이, ID 대역 루프 방지, DBC 설계 (Phase 3)

• CAN 명령 수신 → 실제 모터 제어 연결, 가변저항 실시간 반영 (Phase 3.5)

• ~~가변저항 → ADC → CAN → 게이트웨이 → 모터로 이어지는 전체 데이터 체인 완성~~

정정(2026-10-25): 실제 경로는 가변저항 → ADC → CAN1 → 버스 → CAN2 → 모터이며(8.1절), 게이트웨이 전달은 이 경로에 들어 있지 않다.

다음 단계

• Phase 4: FreeRTOS 이식

• Phase 5: 라즈베리파이4 + MCP2515 + SocketCAN 노드 결합, 완전 분리된 물리 버스 구성 및 아비트레이션 실측
