rkalsdud/MARCO/보고서/MARCO_Phase1-4_결과보고서.docx

MARCO 프로젝트

Motor And Real-time Control Over CAN

Phase 1-4 결과 보고서

PWM + 타이머 — 모터 속도 제어

2026년 7월 9일

항목 | 내용
대상 보드 | STM32 Nucleo-F446RE
단계 | Phase 1-4 — TIM3 PWM으로 모터 속도 제어
목표 | PA6(TIM3_CH1)으로 PWM 생성, Motor_SetSpeed()로 속도 단계별 제어
결과 | PWM 파형 정상 생성, 모터 30%→70%→100%→정지 속도 변화 확인 ✅

# 목차

1. 개요 및 목표

✓ 작업 요약

• TIM3 CH1로 84MHz 클럭 기준 1kHz PWM을 생성하고(PSC=83, ARR=999), Motor_SetSpeed()로 듀티를 제어했다.

• CubeMX 재생성으로 인한 CAN 설정 초기화(ISSUE 010), Motor_SetSpeed 매개변수 오버플로우(ISSUE 011)를 해결했다.

• 모터 속도를 30%→70%→100%→정지 순서로 변화시키며 Serial Monitor로 검증했다.

2. PWM 이론 및 클럭 계산

3. CubeMX 설정 및 소프트웨어 구현

4. 데이터시트 확인 항목

5. 검증 결과

6. 트러블슈팅 요약

7. 결론

# 1. 개요 및 목표

Phase 1-4는 TIM3 타이머의 PWM 출력 기능을 이용해 모터 속도를 단계적으로 제어하는 단계다. Phase 1-3에서 방향 제어(AIN1/AIN2/STBY)만 구현했던 것에 이어, PWMA 핀에 실제 PWM 신호를 연결해 속도까지 제어한다.

목표 | 완료 기준 | 결과
TIM3 CH1 PWM 설정 | 1kHz 주파수로 PA6에서 PWM 출력 | ✅
Motor_SetSpeed() 구현 | 0~999 duty 범위로 속도 조절 | ✅
PWMA 배선 변경 | STM32 3.3V 고정 → PA6 연결 | ✅
속도 단계 검증 | 30%→70%→100%→정지 순차 변화 | ✅
Serial Monitor 확인 | Speed: 30%/70%/100% 출력 | ✅

# 2. PWM 이론 및 클럭 계산

## 2.1 TIM3 클럭 확정

RM0390 RCC 장에서 RCC_DCKCFGR 레지스터의 TIMPRE 비트를 확인했다. 리셋값이 0이므로, APB1 prescaler가 1보다 클 때 타이머 클럭은 APB1 클럭의 2배가 된다.

APB1 클럭 = 42MHz (HCLK 84MHz / APB1 prescaler 2)
TIMPRE = 0 (리셋값) → APB1 prescaler>1 이므로 TIM3 클럭 = APB1 × 2
TIM3 클럭 = 42MHz × 2 = 84MHz

## 2.2 PWM 주파수 계산 (목표 1kHz)

PWM 주파수 = TIM3 클럭 / (PSC+1) / (ARR+1)

1000Hz = 84,000,000 / (PSC+1) / (ARR+1)

PSC = 83 → PSC+1 = 84
ARR = 999 → ARR+1 = 1000

검증: 84,000,000 / 84 / 1000 = 1000Hz ✅

## 2.3 듀티 제어 원리

카운터가 0부터 ARR(999)까지 반복해서 세는 동안, 카운터 값이 CCR보다 작으면 PA6 핀이 HIGH, 크거나 같으면 LOW가 된다. CCR 값을 바꾸면 HIGH 구간의 비율(듀티)이 바뀐다.

카운터 < CCR → PA6 HIGH
카운터 >= CCR → PA6 LOW

CCR=300 → 듀티 30% (0~299 HIGH, 300~999 LOW)
CCR=700 → 듀티 70%
CCR=999 → 듀티 99.9% (사실상 100%)

PSC, ARR: 초기 설정 후 고정 (주파수 결정)
CCR: 런타임에서 계속 변경 (듀티 결정)

# 3. CubeMX 설정 및 소프트웨어 구현

## 3.1 CubeMX TIM3 설정

항목 | 값
Channel | PWM Generation CH1
Prescaler | 83
Counter Period (ARR) | 999
Pulse (초기 CCR) | 500
GPIO 핀 | PA6 (Alternate Function Push Pull, AF2)

## 3.2 PWM 시작 코드

/* USER CODE BEGIN 2 */
HAL_TIM_PWM_Start(&htim3, TIM_CHANNEL_1);
/* USER CODE END 2 */

## 3.3 Motor_SetSpeed 함수

초기 버전에서 매개변수 타입 버그(uint8_t)가 있었다. uint16_t로 수정한 최종 버전이다. 상세 내용은 6장 참조.

void Motor_SetSpeed(uint16_t duty){
if (duty > 999) duty = 999; // 방어 로직: 클램핑
__HAL_TIM_SET_COMPARE(&htim3, TIM_CHANNEL_1, duty);
}

## 3.4 while 루프 속도 단계 제어

Motor_Forward();
Motor_SetSpeed(300);
printf("Speed: 30%%\r\n");
HAL_Delay(2000);

Motor_SetSpeed(700);
printf("Speed: 70%%\r\n");
HAL_Delay(2000);

Motor_SetSpeed(999);
printf("Speed: 100%%\r\n");
HAL_Delay(1000);

Motor_Stop();
printf("Motor stopped\r\n");
HAL_Delay(1000);

# 4. 데이터시트 확인 항목

항목 | 소스 | 찾은 내용 | 근거 위치
PA6 Morpho 위치 | UM1724 | CN10 13번 | Morpho 커넥터 핀 배치표
PA6 AF 번호 | DS10693 | AF2 = TIM3_CH1 | Table 10. Pin descriptions
TIMPRE 비트 리셋값 | RM0390 RCC 장 | 0 | RCC_DCKCFGR 레지스터
TIM3 클럭 계산식 | RM0390 RCC 장 | APB1 prescaler>1 → ×2 | 타이머 클럭 설명
TIM3 최대 타이머 클럭 | DS10693 | 90MHz (TIMPRE=0) | Table 60. TIMx characteristics
TIMx_PSC 비트폭 | RM0390 17장 | 16비트 (분주비 1~65536) | TIMx_PSC 레지스터
TIMx_ARR 비트폭 | RM0390 17장 | 16비트 (0~65535) | TIMx_ARR 레지스터
TB6612FNG PWM 최대 주파수 | TB6612FNG 데이터시트 | 100kHz (목표 1kHz 충분히 여유) | Electrical characteristics

# 5. 검증 결과

## 5.1 PWM 파형 관찰

로직분석기로 PA6 파형을 관찰했다. 듀티 값(300/700/999)에 따라 HIGH 구간의 비율이 육안으로 명확히 다르게 확인됐다. 정밀 캡처 이미지는 확보하지 못했으나 실시간 관찰로 정상 동작을 확인했다.

## 5.2 Serial Monitor 출력

CAN clk enabled
CAN Start: 0 CAN_error: 0
CAN Notif: 0 CAN_error: 0
Speed: 30%
Speed: 70%
Speed: 100%
Motor stopped
Speed: 30%
...

✓ Phase 1-4 검증 완료

PA6에서 1kHz PWM 정상 생성

듀티 30%/70%/100%에 따라 모터 속도 명확히 변화

CAN Start/Notif 오류 0으로 정상 (ISSUE 010 해결 후)

Motor_SetSpeed 오버플로우 수정 후 정확한 듀티 적용 (ISSUE 011 해결 후)

# 6. 트러블슈팅 요약

상세 내용은 MARCO_트러블슈팅_로그.docx ISSUE 010, 011을 참조한다.

번호 | 증상 | 원인 | 해결
010 | CAN Start/Notif 오류 재발 (0x20000, 0x60000) | CubeMX가 TIM3 추가로 재생성되며 CAN RX 핀 Pull 설정이 초기화됨 (코드로 직접 고쳤던 msp.c가 재생성 시 덮어써짐) | CubeMX GUI에서 PB8 Pull-up 설정 → .ioc 파일에 저장
011 | Motor_SetSpeed 오버플로우 | 매개변수 타입이 uint8_t(최대 255)로 선언되어 300/700/999 입력 시 값이 깨짐 | uint16_t로 변경

⚠ 재발 방지 원칙

CubeMX가 자동 생성하는 파일(msp.c 등)의 설정은 코드로 직접 고치지 말고 CubeMX GUI에서 변경한다.

페리퍼럴을 추가/재생성할 때마다 이전 단계의 Serial Monitor 결과가 여전히 정상인지 재확인한다.

매개변수 타입은 항상 실제 값 범위를 표현할 수 있는지 확인한다.

# 7. 결론

Phase 1-4의 목표를 달성했다. TIM3 CH1으로 1kHz PWM을 생성하고, Motor_SetSpeed() 함수로 0~999 범위의 듀티를 제어해 모터 속도를 30%, 70%, 100% 단계로 변화시켰다. 이 과정에서 CubeMX 재생성과 관련된 설정 유지 문제, 매개변수 타입 오버플로우 문제를 경험하고 해결했다.
