rkalsdud/MARCO/보고서/MARCO_Phase0__환경_설정_.docx

MARCO 프로젝트

Motor And Real-time Control Over CAN

Phase 0 결과 보고서 — 개발 환경 구축

본 문서는 CubeMX/CMake 환경 설정을 기록한다. 이 설정은 Phase 1~3 전체가 하나의 .ioc/프로젝트를 공유하며 누적 확장한 결과다.

# 1. 개요

✓ 핵심 원칙

• CubeMX .ioc 설정은 Phase마다 새로 만드는 것이 아니라, 하나의 프로젝트에 페리퍼럴을 순서대로 누적 추가하는 방식으로 진행했다.

• Phase 1-3(GPIO) → 1-4(TIM3) → 1-5(ADC1) → 3(CAN1/CAN2) 순서로 같은 .ioc 파일에 설정이 쌓였다.

• 다만 설정을 공유하기 때문에, CubeMX 재생성 시 코드로 직접 수정했던 값(예: GPIO Pull 설정)이 초기화되는 부작용이 있었다 (ISSUE 010).

# 2. 하드웨어 및 툴체인

항목 | 내용
보드 | Nucleo-F446RE (STM32F446RE, Cortex-M4, 84MHz)
IDE/편집기 | VSCode
빌드 시스템 | STM32CubeMX 생성 코드 + CMake (Ninja 제너레이터)
툴체인 | gnu-tools-for-stm32 (arm-none-eabi-gcc)
업로드/디버그 | STM32CubeProgrammer, ST-LINK
시리얼 모니터 | USART2 (ST-LINK 가상 COM 포트, 별도 배선 불필요)

# 3. CubeMX 페리퍼럴 설정 (누적 순서)

## 3.1 시스템 클럭 (SystemClock_Config)

HSI(16MHz) → PLL → SYSCLK 84MHz로 구성했다. 이 값은 이후 모든 Phase의 타이머/CAN 비트타이밍 계산의 기준이 된다.

설정 | 값
오실레이터 소스 | HSI (16MHz)
PLLM / PLLN / PLLP | 16 / 336 / DIV4
SYSCLK | 84MHz
AHB Prescaler | DIV1
APB1 Prescaler | DIV2 (42MHz)
APB2 Prescaler | DIV1 (84MHz)
Flash Latency | 2

## 3.2 GPIO (Phase 1-3에서 추가)

핀 | 용도 | 설정
PC0, PC1, PC2 | 모터 방향 제어(AIN0/AIN1/STBY) | GPIO_Output, Push-Pull, NoPull, Low Speed
PA5 | 보드 내장 LED (LD2) | GPIO_Output, Push-Pull
PC13 | 보드 내장 버튼 (B1) | GPIO_EXTI Falling, NoPull

## 3.3 TIM3 — PWM (Phase 1-4에서 추가)

설정 | 값
채널 | TIM_CHANNEL_1 (PA6)
Prescaler | 83
Counter Period (ARR) | 999
Counter Mode | Up
PWM Mode | PWM Mode 1
Polarity | High

## 3.4 ADC1 (Phase 1-5에서 추가)

설정 | 값
채널 | ADC_CHANNEL_13 (PC3)
Resolution | 12비트
Clock Prescaler | PCLK/4
Sampling Time | 3 Cycles
Scan/Continuous Mode | Disable
Data Align | Right

## 3.5 CAN1 / CAN2 (Phase 3에서 추가)

설정 | 값
CAN1 핀 | PB8(RX)/PB9(TX)
CAN2 핀 | PB5(RX)/PB6(TX)
Prescaler | 6
BS1 / BS2 | 11TQ / 2TQ
SJW | 1TQ
통신속도(근사) | 500kbps

# 4. CMake / VSCode 설정 이슈

Debug/Release 빌드 타입이 실제로 적용되지 않던 문제가 있었다. 원인은 VSCode의 cmake.configureArgs에 CMAKE_BUILD_TYPE이 명시되지 않아, CMake Presets의 Release 설정이 실제 컴파일에 반영되지 않았기 때문이다.

// .vscode/settings.json

"cmake.configureArgs": [

"-DCMAKE_COMMAND=cube-cmake",

"-DCMAKE_BUILD_TYPE=Release"

]

⚠ 확인 방법

• 빌드 후 build/CMakeCache.txt에서 CMAKE_BUILD_TYPE 값을 확인한다.

• Debug/Release 빌드 산출물(.elf)의 파일 크기를 비교한다 — Release가 큰 폭으로 작으면 최적화가 실제로 적용된 것이다.

• STM32CubeProgrammer로 업로드할 때는 build/Release/*.elf 경로를 명시적으로 선택해야 한다 — 이전 Debug 경로가 남아있으면 설정과 무관하게 옛 바이너리가 계속 실행된다.

# 5. 재현 시 유의사항

✓ 이 환경을 재현할 때 확인할 것

• .ioc 파일은 프로젝트 전체가 공유하므로, CubeMX에서 코드 재생성 시 이전에 직접 코드로 수정한 핀 설정(Pull 등)이 초기화될 수 있다 — 반드시 CubeMX GUI에서 직접 설정을 반영한 뒤 재생성해야 한다.

• printf를 쓰려면 USER CODE Includes 구역에 #include <stdio.h>를 직접 추가해야 한다 — CubeMX가 자동으로 포함해주지 않는다.

• __io_putchar() 함수로 printf를 USART2로 리다이렉트해야 Serial Monitor에서 출력이 보인다.
