rkalsdud/MARCO/others/MARCO kicad.png

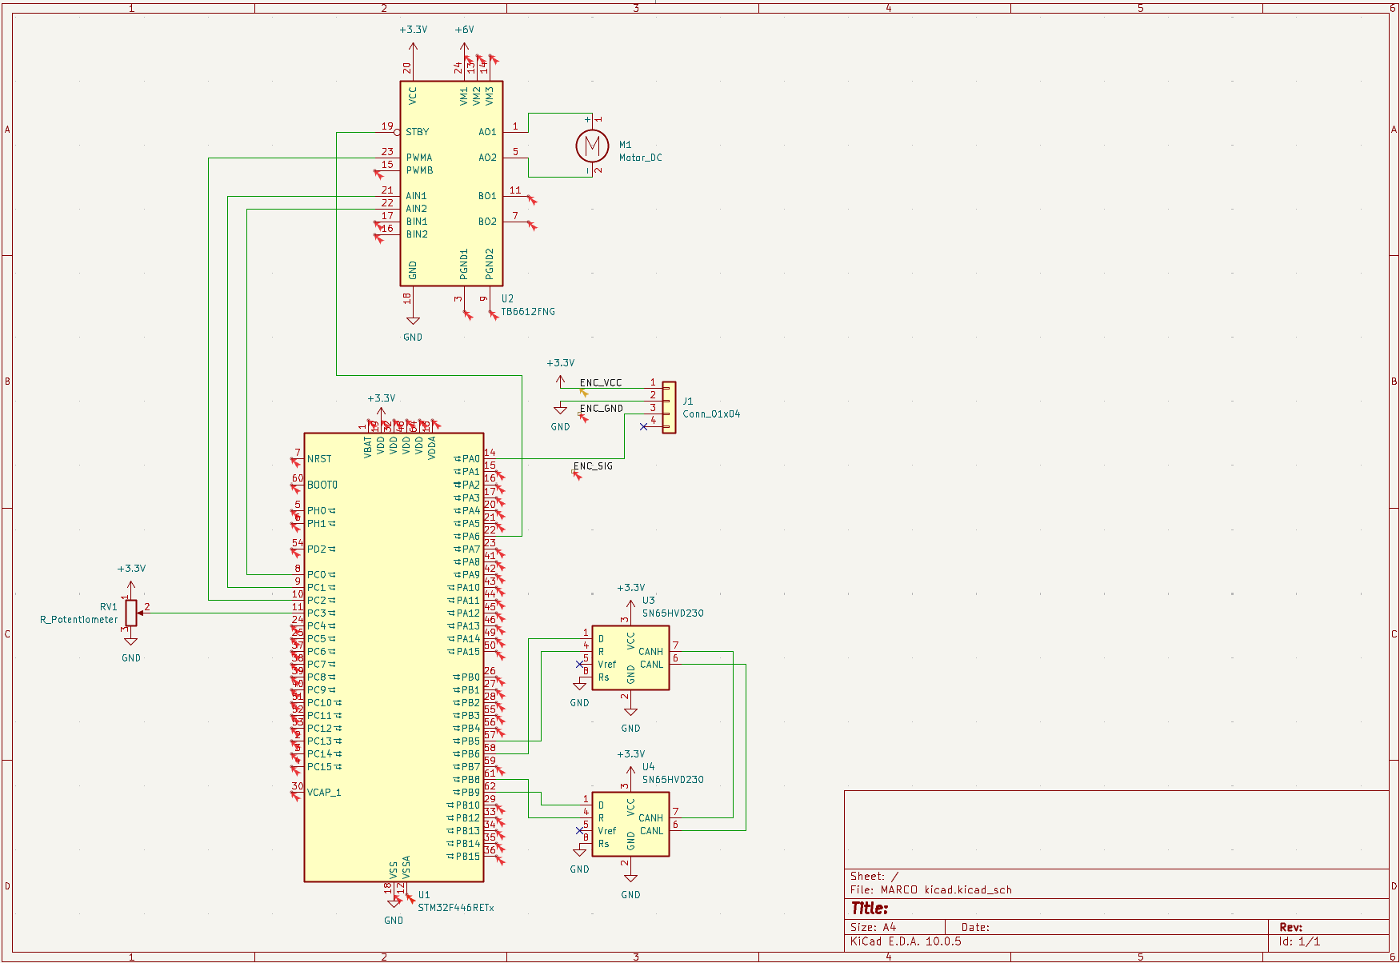
others/MARCO kicad.png
