rkalsdud/MARCO/others/MARCO kicad.pdf

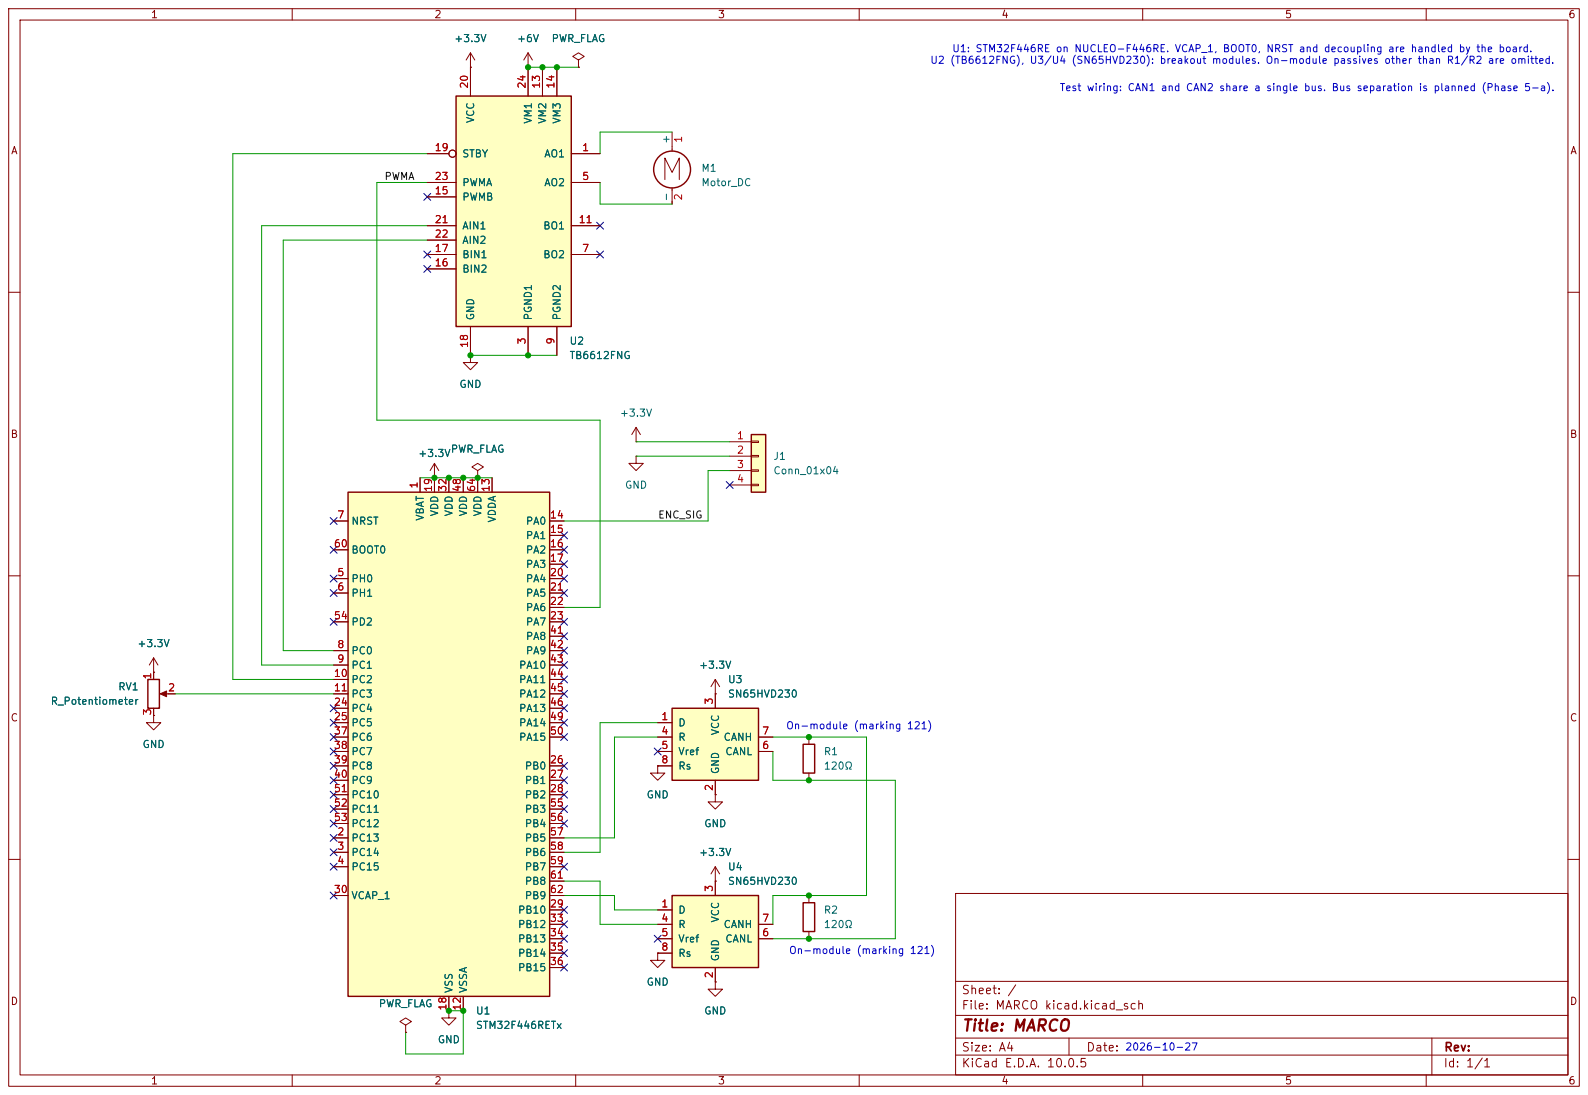
[picture p11: page 1]

Test wiring: CAN1 and CAN2 share a single bus. Bus separation is planned (Phase 5-a).

Size: A4 | Rev:
KiCad E.D.A. 10.0.5 | Id: 1/1
