rkalsdud/MARCO/others/MARCO kicad.kicad_sch

## KiCad design others/MARCO kicad.kicad_sch (2026-10-27)

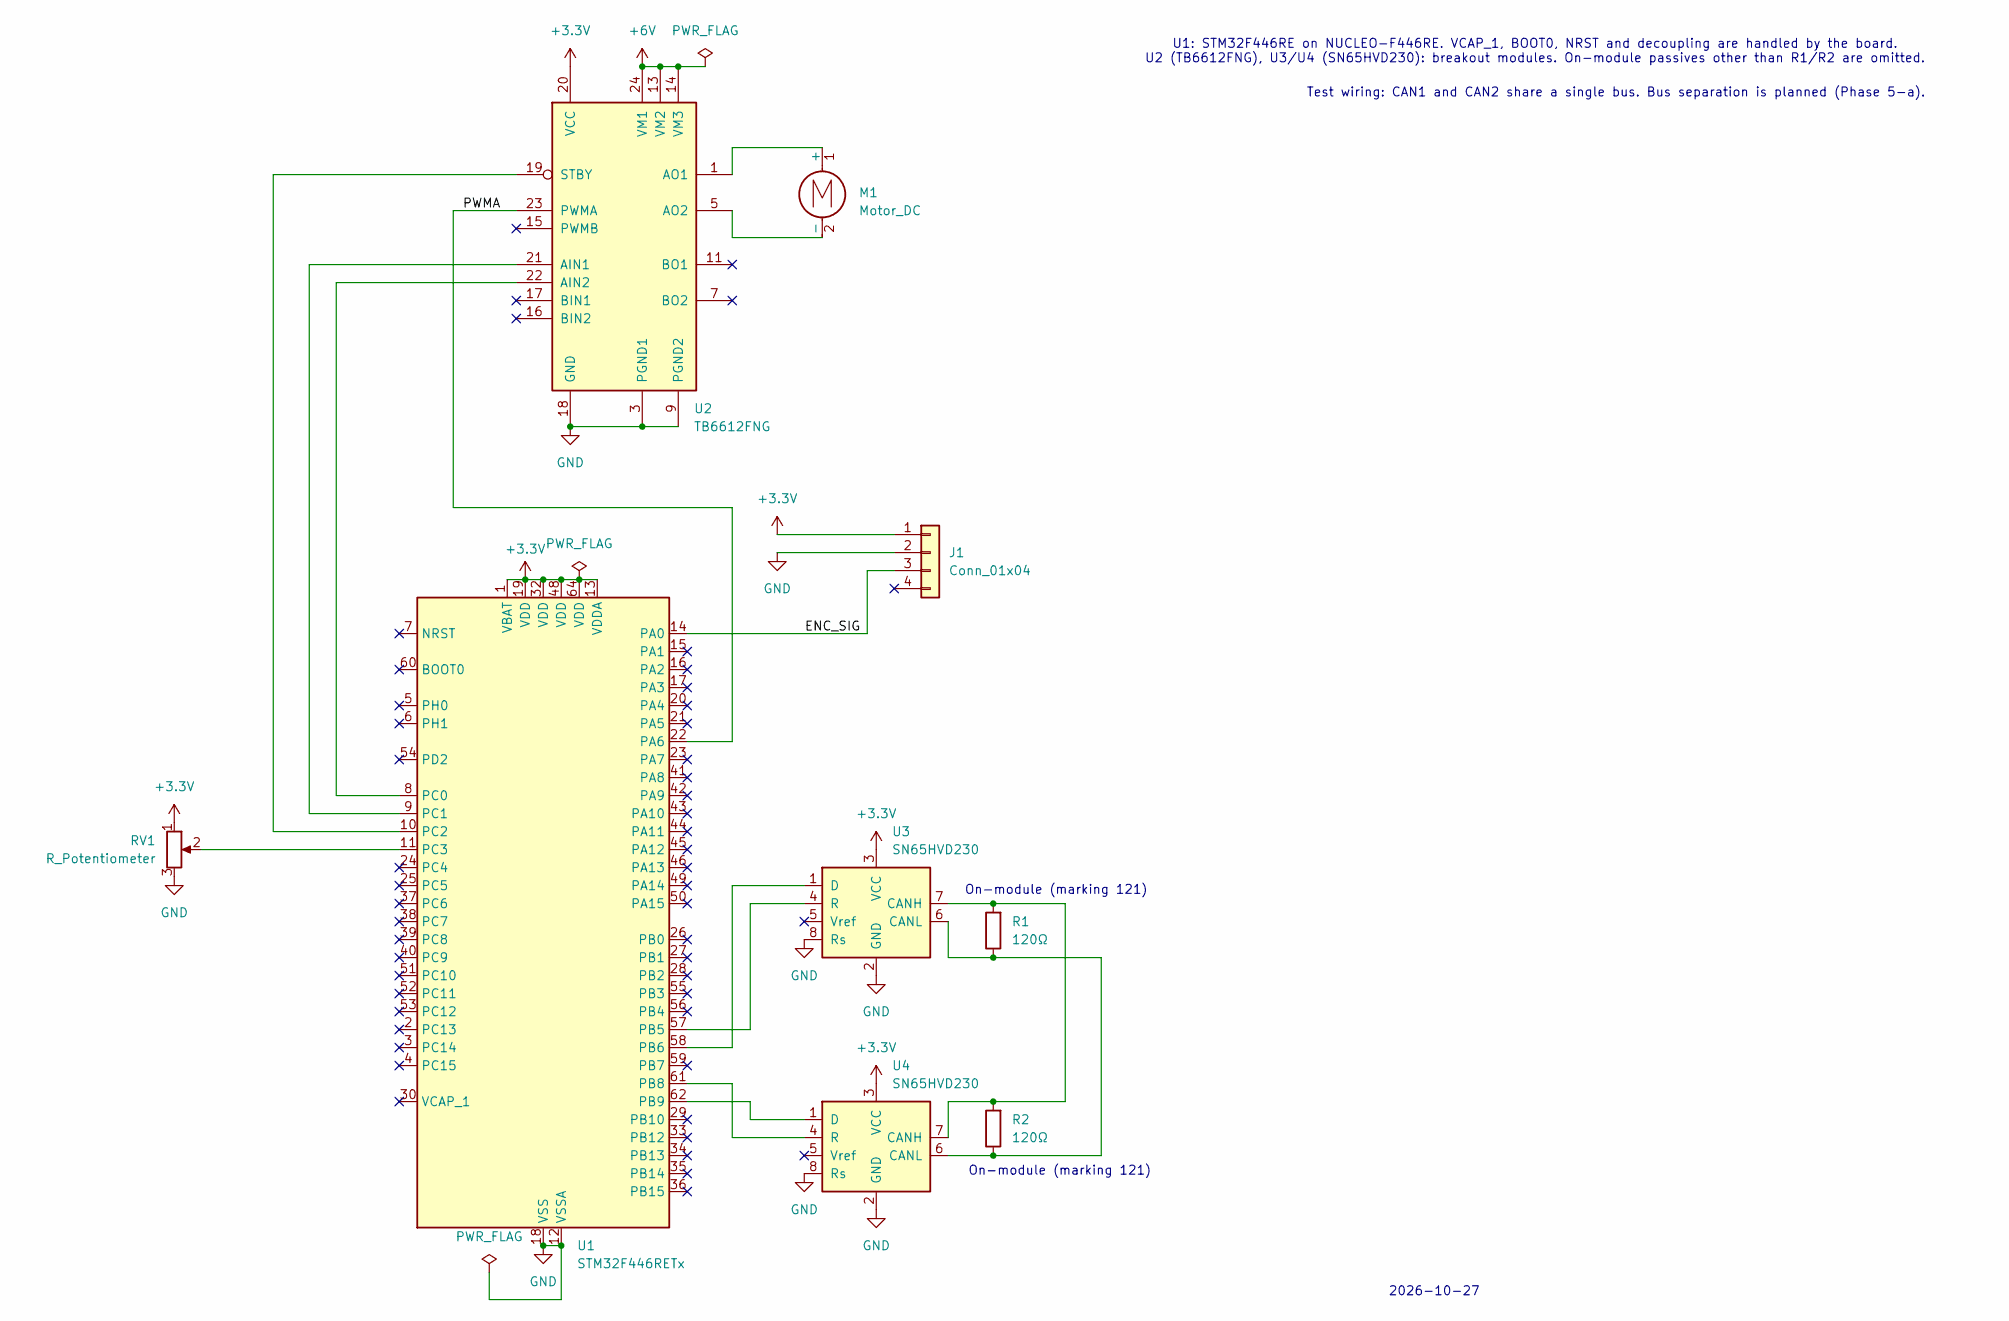
[picture p12: schematic MARCO kicad.kicad_sch]

Parts:
J1: Conn_01x04
M1: Motor_DC
R1, R2: 120Ω
RV1: R_Potentiometer
U1: STM32F446RETx; LQFP-64_10x10mm_P0.5mm
U2: TB6612FNG; SSOP-24_5.3x8.2mm_P0.65mm
U3, U4: SN65HVD230; SOIC-8_3.9x4.9mm_P1.27mm

Connections:
+3.3V: J1.1, RV1.1, U1.1 (VBAT), U1.13 (VDDA), U1.19 (VDD), U1.32 (VDD), U1.48 (VDD), U1.64 (VDD), U2.20 (VCC), U3.3 (VCC), U4.3 (VCC)
+6V: U2.13 (VM2), U2.14 (VM3), U2.24 (VM1)
ENC_SIG: J1.3, U1.14 (PA0)
GND: J1.2, RV1.3, U1.12 (VSSA), U1.18 (VSS), U1.31 (VSS), U1.47 (VSS), U1.63 (VSS), U2.3 (PGND1), U2.4 (PGND1), U2.9 (PGND2), U2.10 (PGND2), U2.18 (GND), U3.2 (GND), U3.8 (Rs), U4.2 (GND), U4.8 (Rs)
unnamed: M1.1 (+), U2.1 (AO1), U2.2 (AO1)
unnamed: M1.2 (-), U2.5 (AO2), U2.6 (AO2)
unnamed: R1.1, R2.1, U3.6 (CANL), U4.6 (CANL)
unnamed: R1.2, R2.2, U3.7 (CANH), U4.7 (CANH)
unnamed: RV1.2, U1.11 (PC3)
unnamed: U1.8 (PC0), U2.22 (AIN2)
unnamed: U1.9 (PC1), U2.21 (AIN1)
unnamed: U1.10 (PC2), U2.19 (STBY)
unnamed: U1.57 (PB5), U3.4 (R)
unnamed: U1.58 (PB6), U3.1 (D)
unnamed: U1.61 (PB8), U4.4 (R)
unnamed: U1.62 (PB9), U4.1 (D)
unnamed: U2.7 (BO2), U2.8 (BO2)
unnamed: U2.11 (BO1), U2.12 (BO1)
PWMA: U1.22 (PA6), U2.23 (PWMA)

Notes on the sheet:
U1: STM32F446RE on NUCLEO-F446RE. VCAP_1, BOOT0, NRST and decoupling are handled by the board. U2 (TB6612FNG), U3/U4 (SN65HVD230): breakout modules. On-module passives other than R1/R2 are omitted.
2026-10-27
On-module (marking 121)
Test wiring: CAN1 and CAN2 share a single bus. Bus separation is planned (Phase 5-a).
