rkalsdud/MARCO/Inc/main.h

#define B1_Pin GPIO_PIN_13
#define B1_GPIO_Port GPIOC
#define AIN0_Pin GPIO_PIN_0
#define AIN0_GPIO_Port GPIOC
#define AIN1_Pin GPIO_PIN_1
#define AIN1_GPIO_Port GPIOC
#define STBY_Pin GPIO_PIN_2
#define STBY_GPIO_Port GPIOC
#define USART_TX_Pin GPIO_PIN_2
#define USART_TX_GPIO_Port GPIOA
#define USART_RX_Pin GPIO_PIN_3
#define USART_RX_GPIO_Port GPIOA
#define LD2_Pin GPIO_PIN_5
#define LD2_GPIO_Port GPIOA
#define TMS_Pin GPIO_PIN_13
#define TMS_GPIO_Port GPIOA
#define TCK_Pin GPIO_PIN_14
#define TCK_GPIO_Port GPIOA
#define SWO_Pin GPIO_PIN_3
#define SWO_GPIO_Port GPIOB
#define CAN_DATA_LEN 8
#define ID_EMERGENCY_STOP 0x100
#define ID_MOTOR_COMMAND 0x101
#define ID_CONTROL_HEARTBEAT 0x1FF
#define ID_MOTOR_STATUS 0x201
#define ID_POT_VALUE 0x202
#define ID_ENCODER_COUNT 0x203
#define ID_DIAG_STATUS 0x210
#define ID_MONITOR_HEARTBEAT 0x2FF
#define DIR_STOP     0
#define DIR_FORWARD  1
#define DIR_REVERSE  2
