rkalsdud/MARCO/(commit log)

2026-08-22 Enhance README with comprehensive project details
    Expanded README with detailed project information including data flow, hardware configuration, measurement results, CAN message design, development environment, repository structure, progress phases, and current limitations.
2026-09-06 Revise Phase 2.5 details in README
    Updated Phase 2.5 description to include assembly level verification and code size measurement.
